OpenKNX/OpenKNX-RasPi-HAT/doc/Renderings/DualKNX_MicroBCU_RaspiHat_V00.03_3D_Render (Klein).png

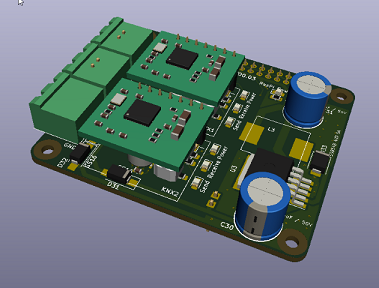
doc/Renderings/DualKNX_MicroBCU_RaspiHat_V00.03_3D_Render (Klein).png
