OpenKNX/OpenKNX-RasPi-HAT/doc/Pictures/IMG_20210311_140433009.jpg

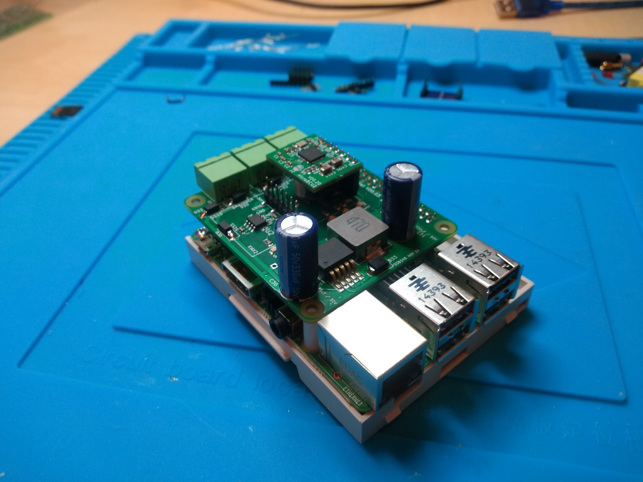
doc/Pictures/IMG_20210311_140433009.jpg
