OpenKNX/OpenKNX-RasPi-HAT/README.md

# OpenKNX-RasPi-HAT

see https://github.com/OpenKNX/OpenKNX/wiki/OpenKNX-RasPi-HAT
