OpenKNX/OpenKNX-RasPi-HAT/doc/DualKNX_MicroBCU_RaspiHat_Schematic_V00.03.png

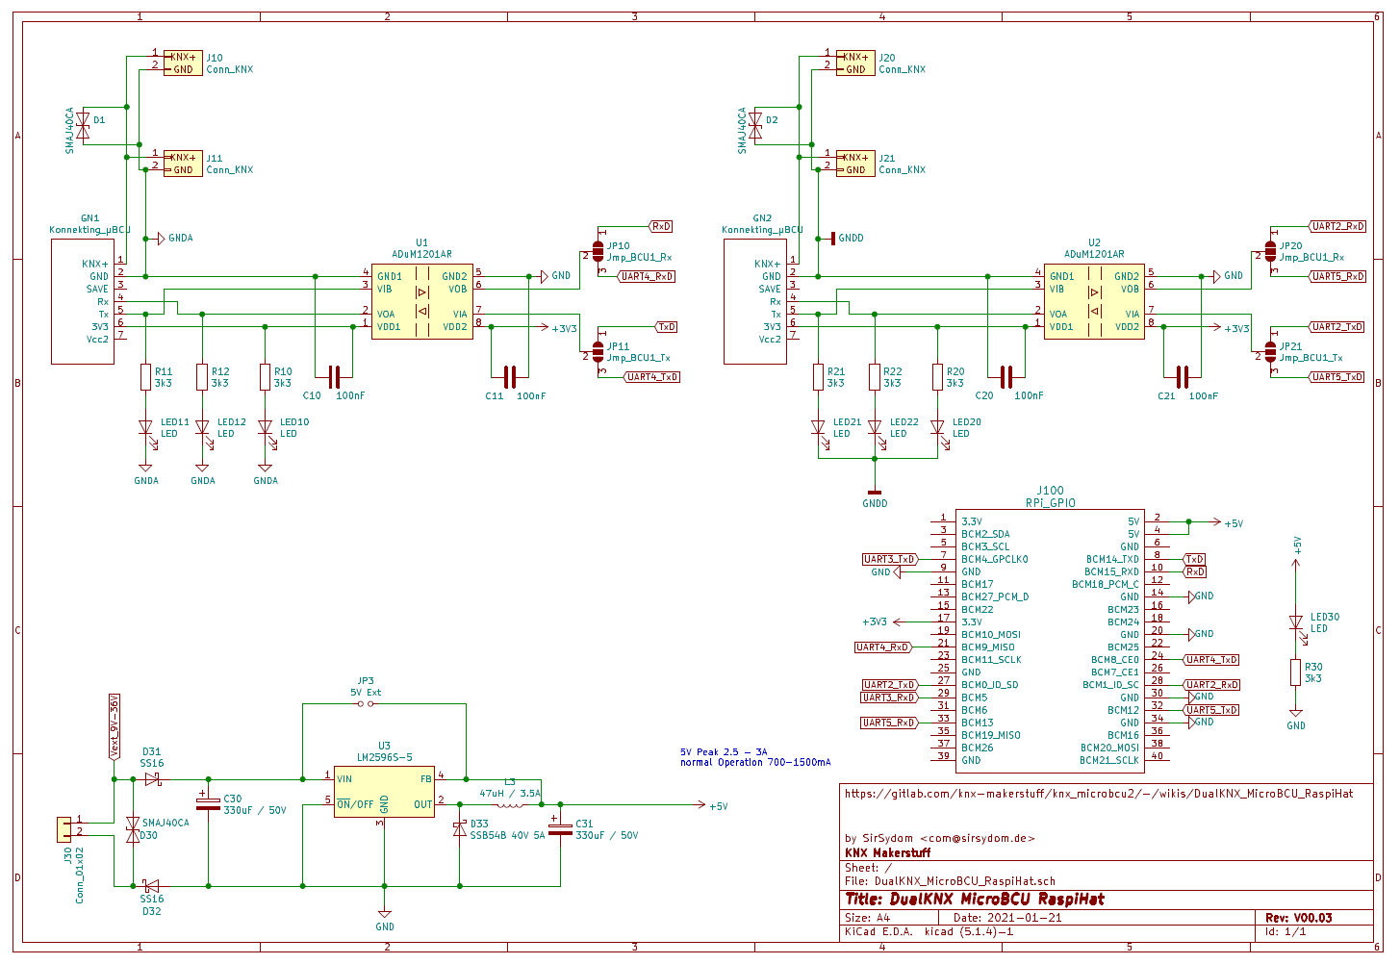
doc/DualKNX_MicroBCU_RaspiHat_Schematic_V00.03.png
