OpenKNX/OpenKNX-RasPi-HAT/doc/Pictures/IMG_20210310_144619610.jpg

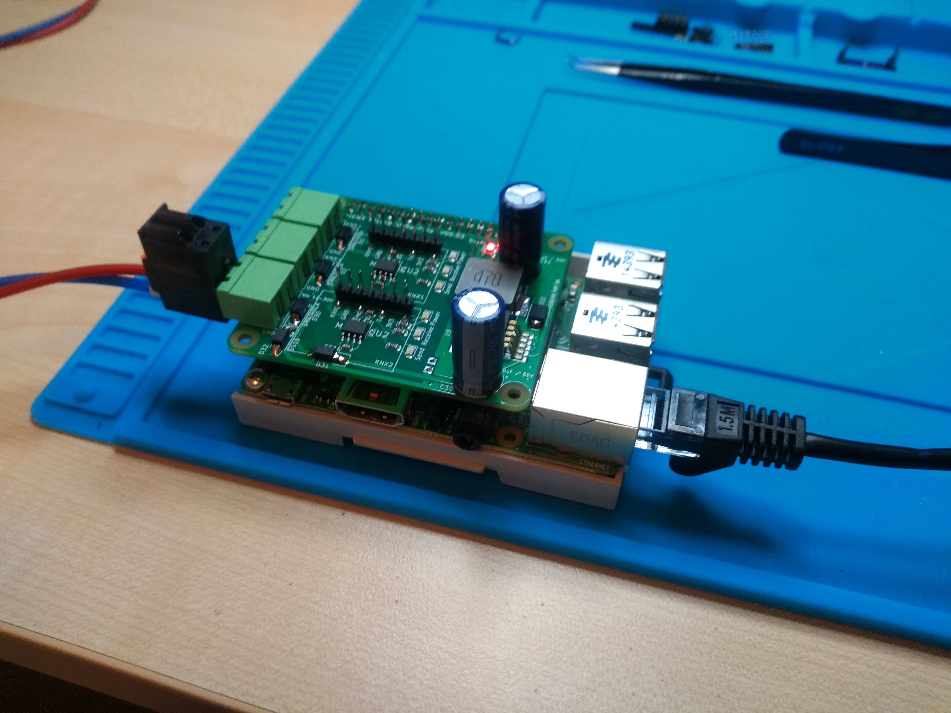
doc/Pictures/IMG_20210310_144619610.jpg
