OpenKNX/OpenKNX-RasPi-HAT/doc/Pictures/IMG_20210310_144640522.jpg

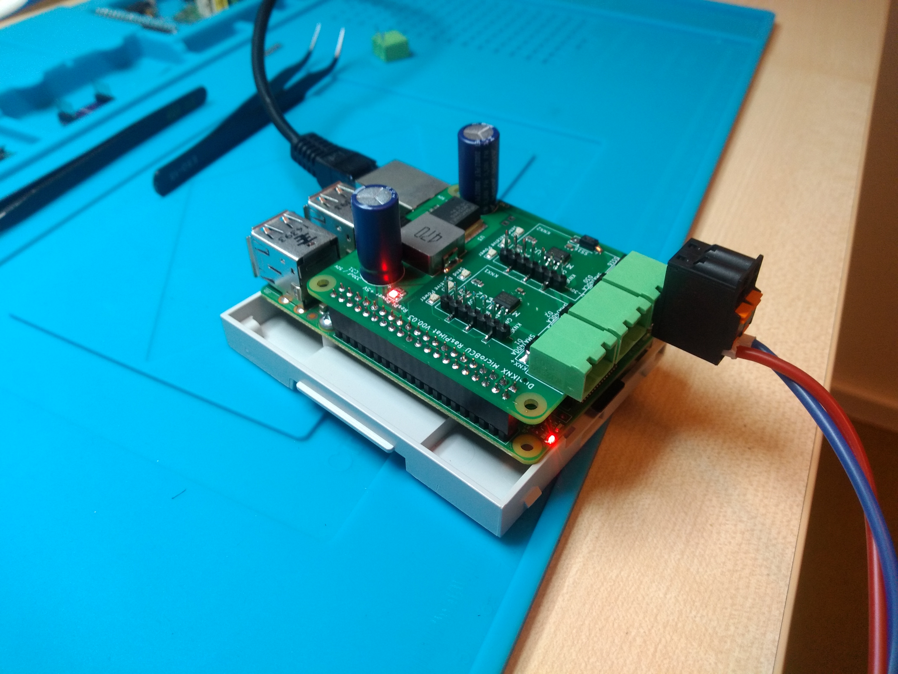
doc/Pictures/IMG_20210310_144640522.jpg
