OpenKNX/OpenKNX-RasPi-HAT/doc/Pictures/IMG_20210310_144718834.jpg

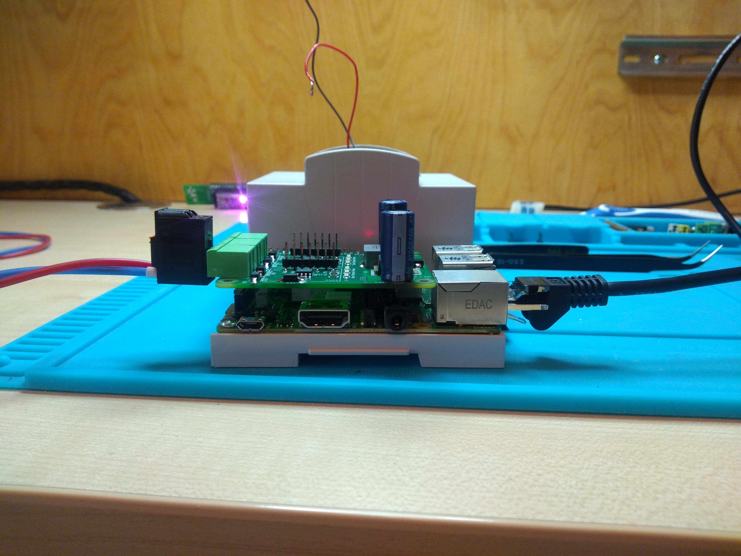
doc/Pictures/IMG_20210310_144718834.jpg
