OpenKNX/OpenKNX-RasPi-HAT/doc/Pictures/IMG_20210310_182440416.jpg

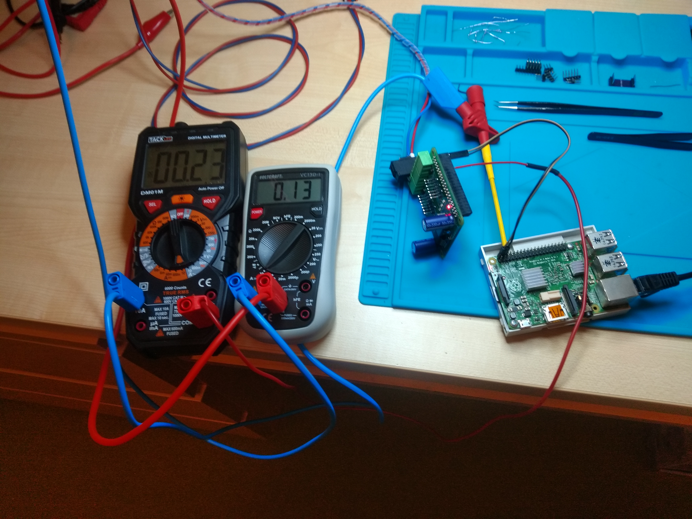
doc/Pictures/IMG_20210310_182440416.jpg
