OpenKNX/OpenKNX-RasPi-HAT/doc/Pictures/IMG_20210310_184042958.jpg

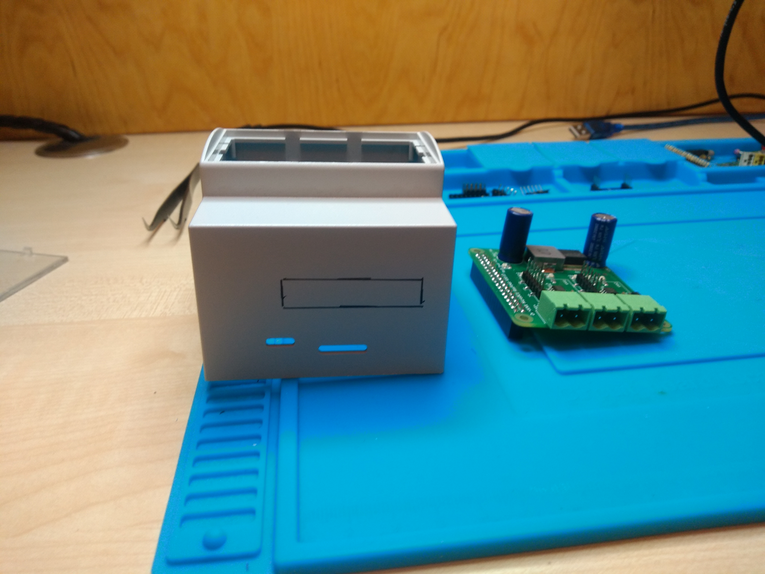
doc/Pictures/IMG_20210310_184042958.jpg
