OpenKNX/OpenKNX-RasPi-HAT/doc/Pictures/IMG_20210310_222531236.jpg

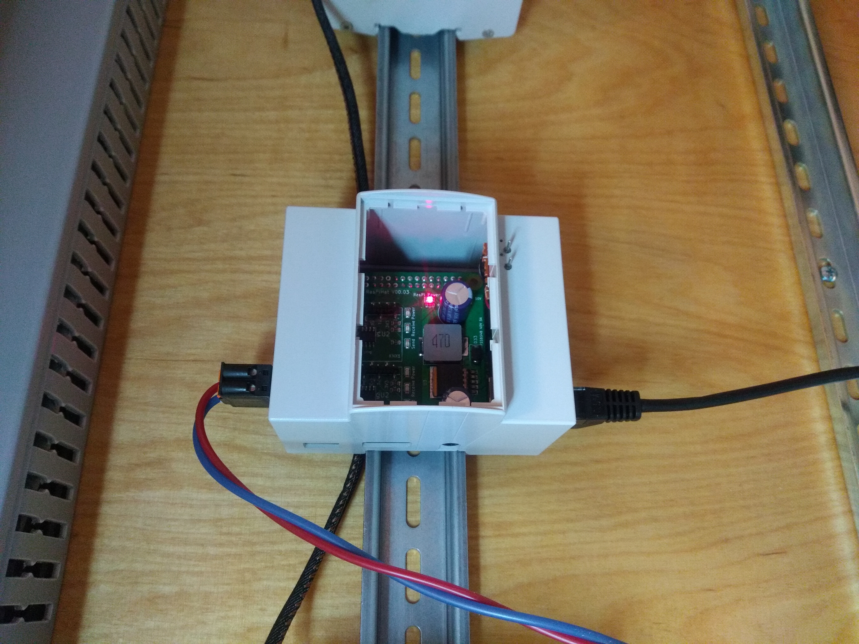
doc/Pictures/IMG_20210310_222531236.jpg
