OpenKNX/OpenKNX-RasPi-HAT/doc/Pictures/IMG_20210311_140428649.jpg

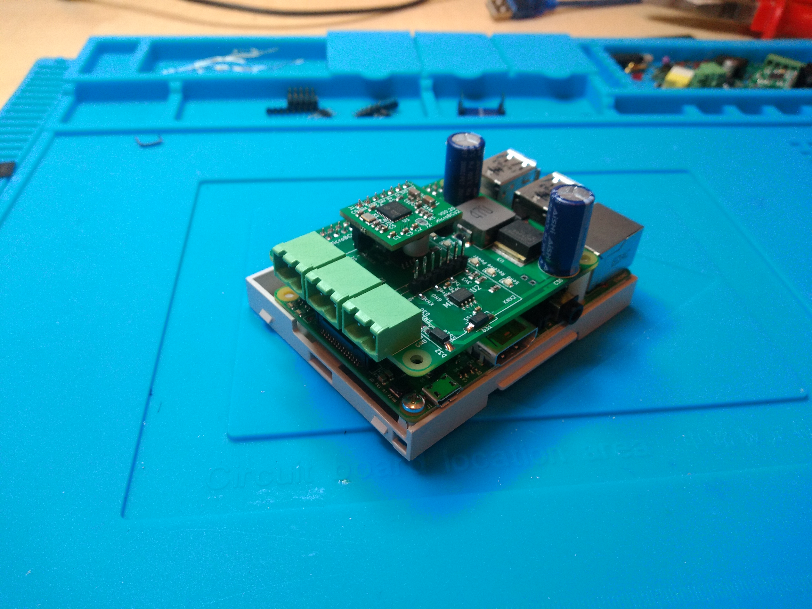
doc/Pictures/IMG_20210311_140428649.jpg
