OpenKNX/OpenKNX-RasPi-HAT/doc/Pictures/IMG_20210311_140438347.jpg

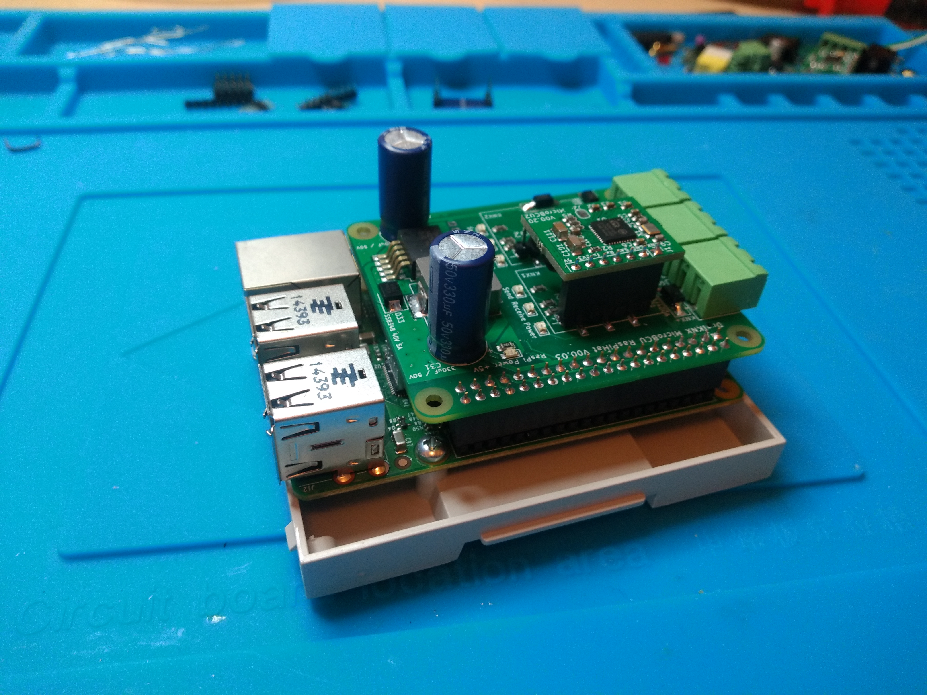
doc/Pictures/IMG_20210311_140438347.jpg
