OpenKNX/OpenKNX-RasPi-HAT/doc/Pictures/IMG_20210311_140441754.jpg

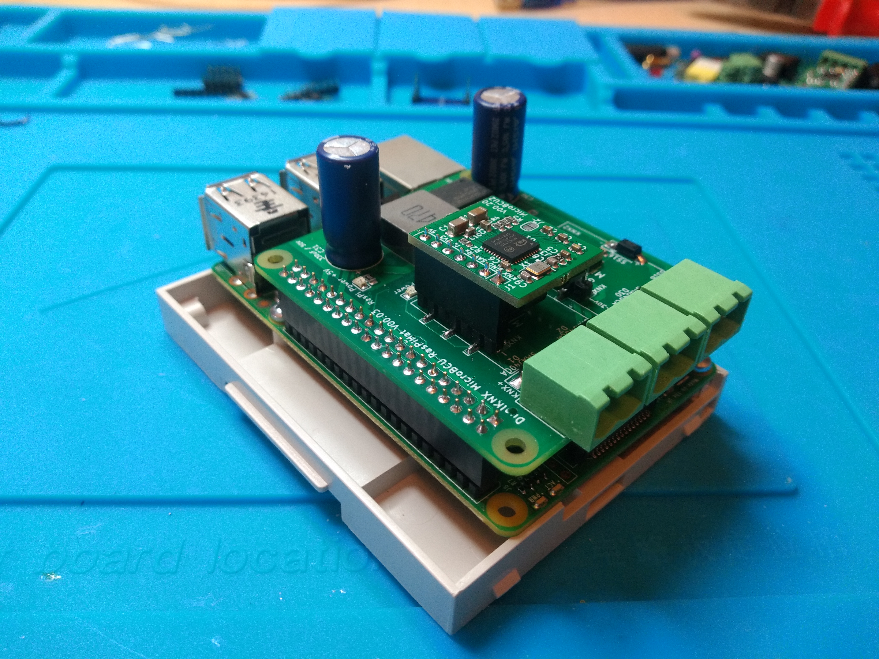
doc/Pictures/IMG_20210311_140441754.jpg
