OpenKNX/OpenKNX-RasPi-HAT/doc/Pictures/IMG_20210311_141130413 (Mittel).jpg

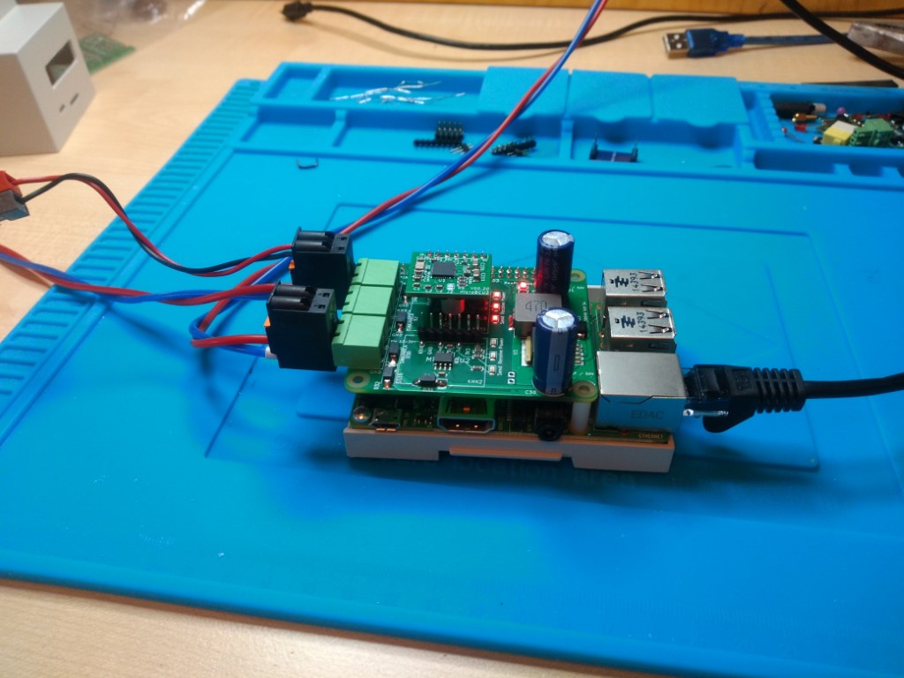
doc/Pictures/IMG_20210311_141130413 (Mittel).jpg
