OpenKNX/OpenKNX-RasPi-HAT/doc/Pictures/IMG_20210311_143212816 (Mittel).jpg

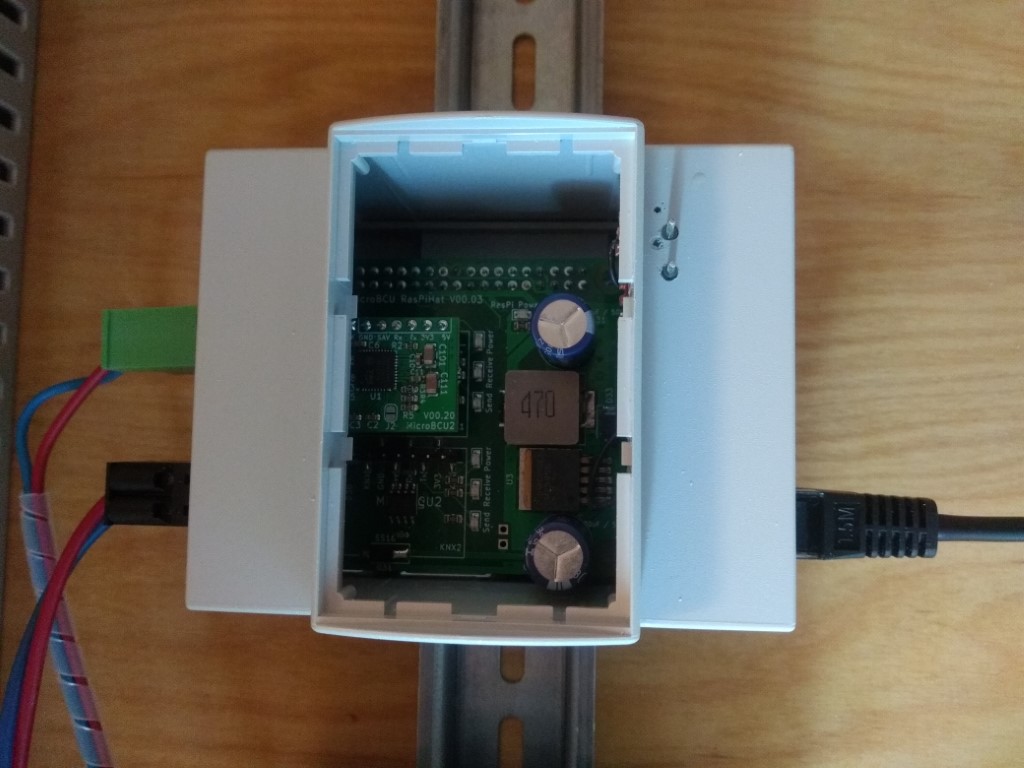
doc/Pictures/IMG_20210311_143212816 (Mittel).jpg
