OpenKNX/OpenKNX-RasPi-HAT/doc/Pictures/IMG_20210311_143313530 (Mittel).jpg

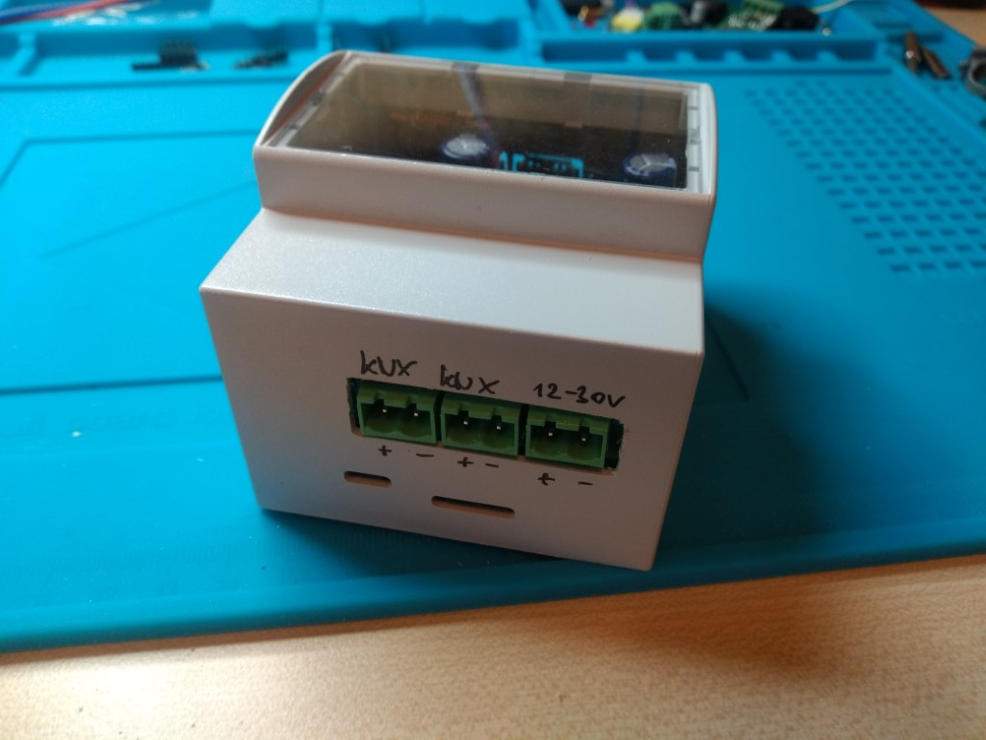
doc/Pictures/IMG_20210311_143313530 (Mittel).jpg
