OpenKNX/OpenKNX-RasPi-HAT/doc/Pictures/IMG_20210311_162232766.jpg

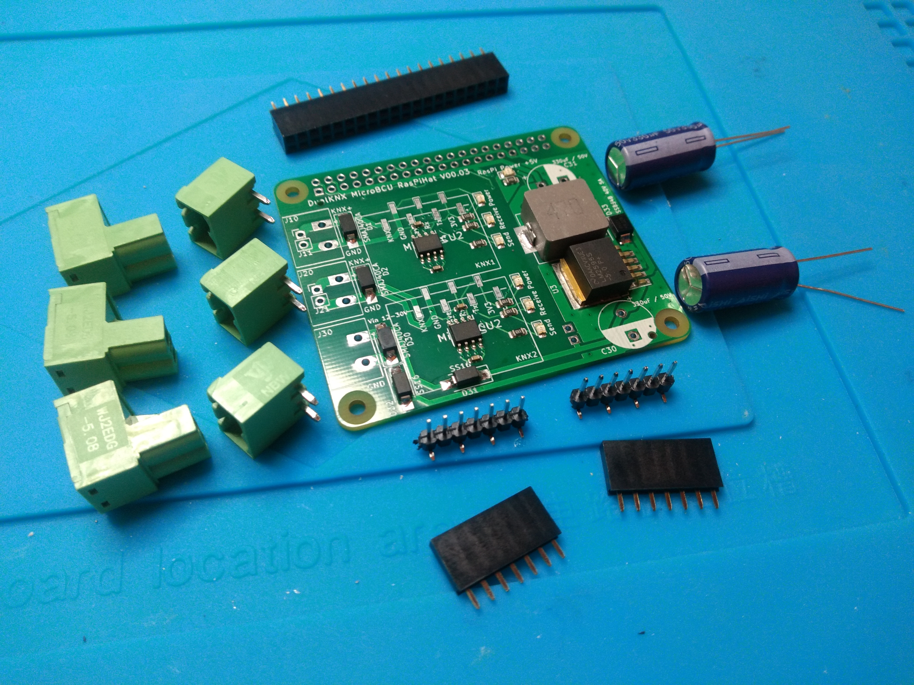
doc/Pictures/IMG_20210311_162232766.jpg
