OpenKNX/OpenKNX-RasPi-HAT/doc/Pictures/IMG_20210311_162318183.jpg

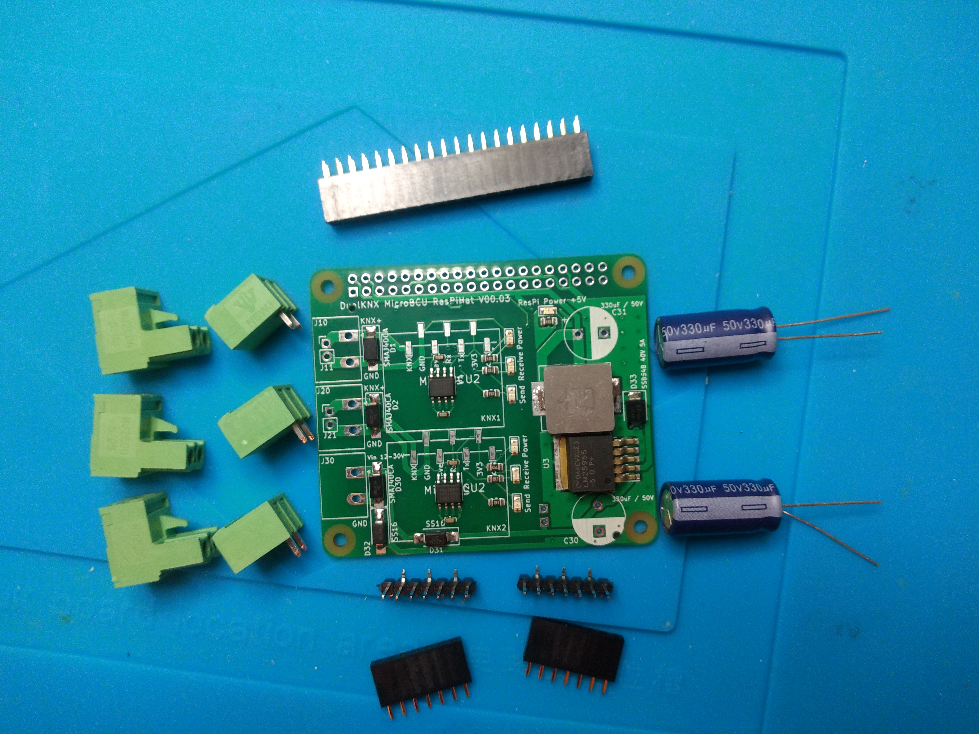
doc/Pictures/IMG_20210311_162318183.jpg
