OpenKNX/OpenKNX-RasPi-HAT/doc/Pictures/OpenKNX-RasPi-HAT_V00.20_kit.jpg

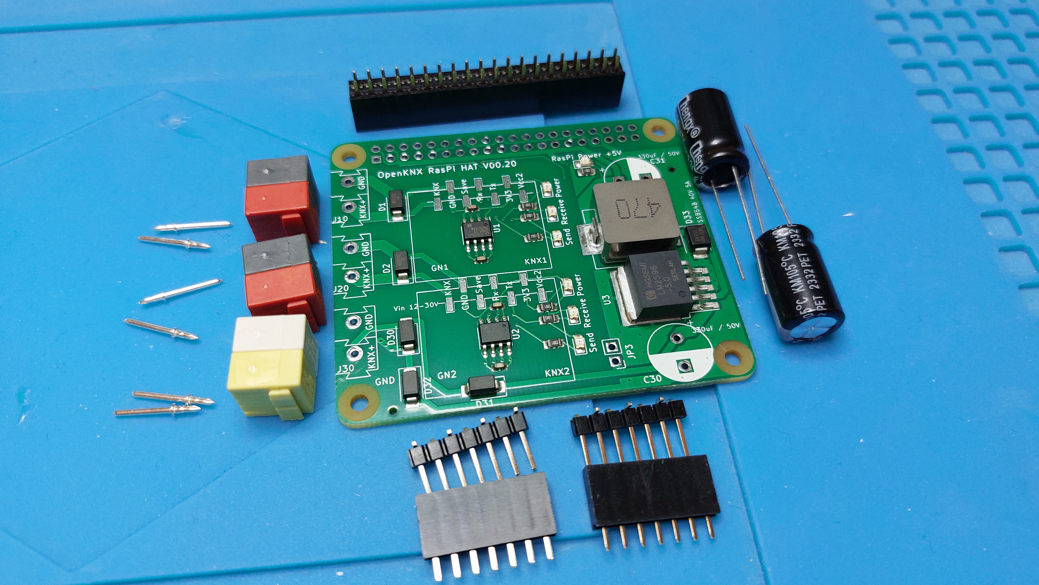
doc/Pictures/OpenKNX-RasPi-HAT_V00.20_kit.jpg
