OpenKNX/OpenKNX-RasPi-HAT/doc/Pictures/RasPi-Case_Prototype01 (Mittel).jpg

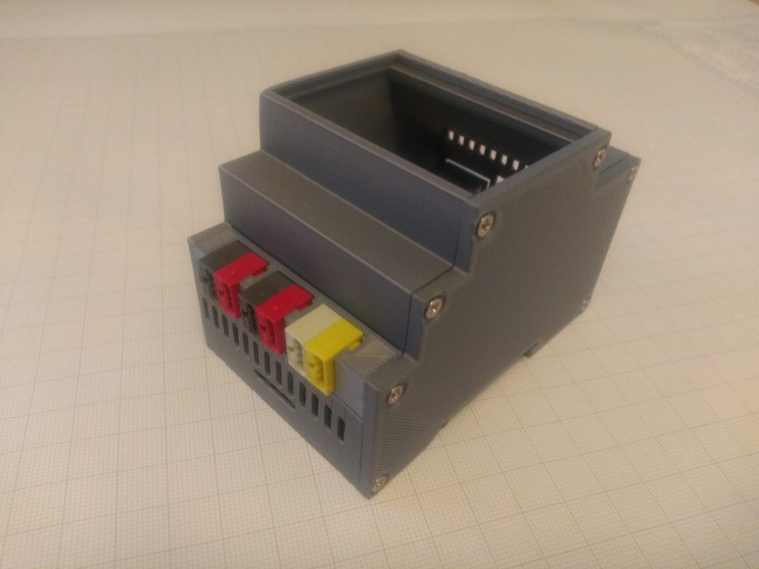
doc/Pictures/RasPi-Case_Prototype01 (Mittel).jpg
