OpenKNX/OpenKNX-RasPi-HAT/doc/Pictures/RasPi-Case_Prototype02.jpg

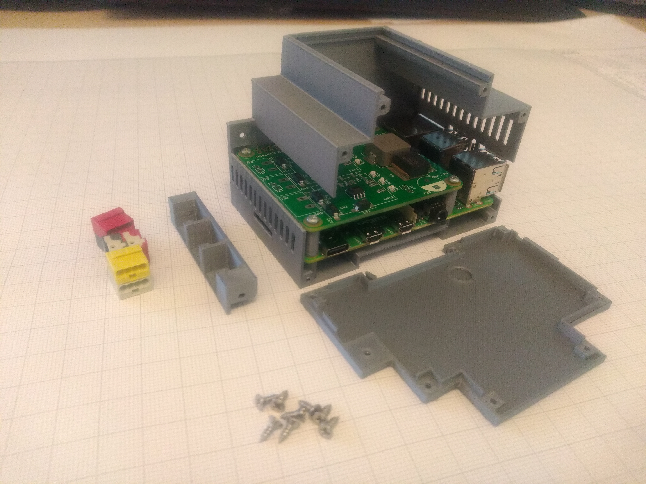
doc/Pictures/RasPi-Case_Prototype02.jpg
