OpenKNX/OpenKNX-RasPi-HAT/doc/Pictures/RasPi-Case_Prototype03.jpg

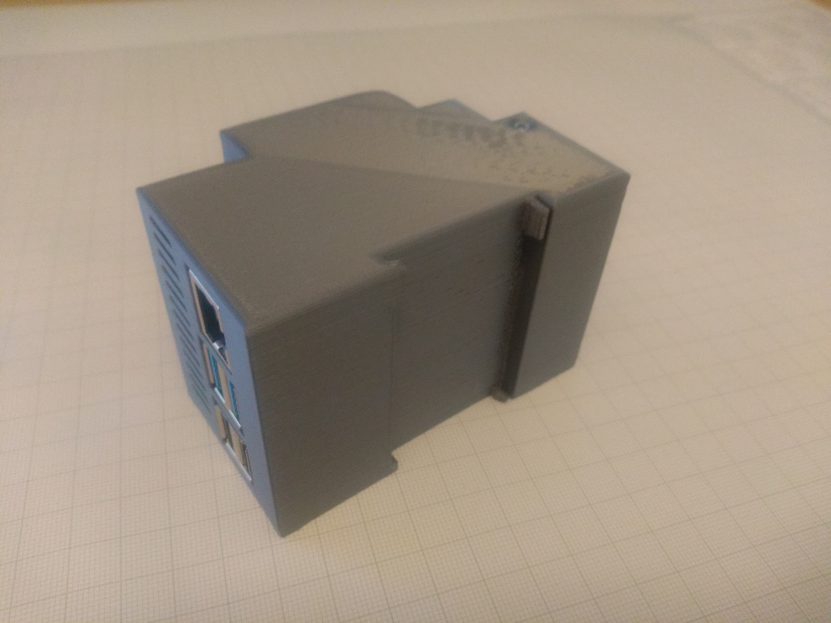
doc/Pictures/RasPi-Case_Prototype03.jpg
