OpenKNX/OpenKNX-RasPi-HAT/doc/RasPi-Case/OpenKNX-RasPi-Case_kit.jpg

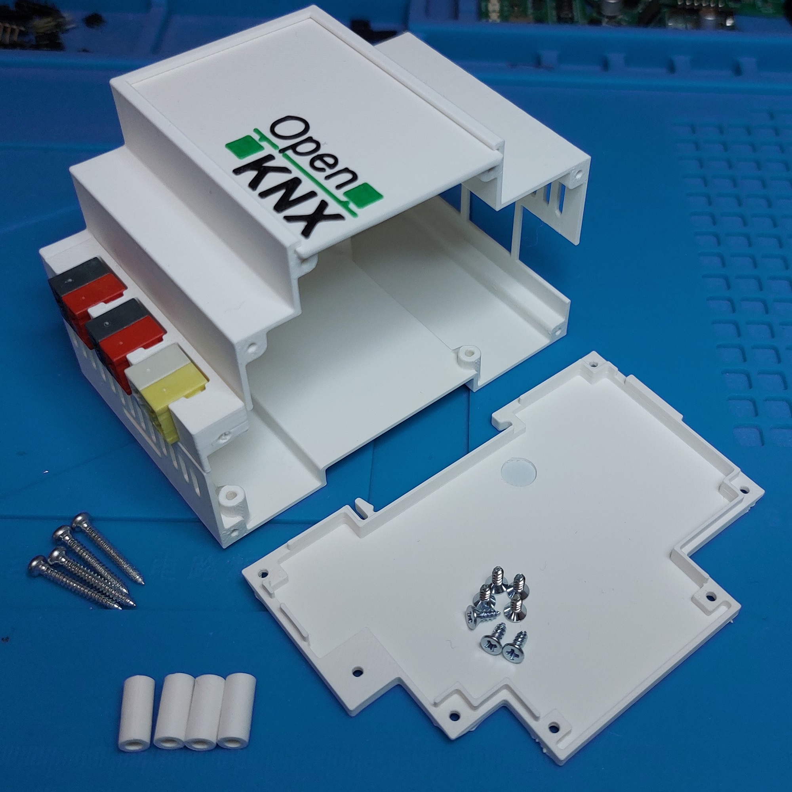
doc/RasPi-Case/OpenKNX-RasPi-Case_kit.jpg
