OpenKNX/OpenKNX-RasPi-HAT/doc/Renderings/3D_bot_V00.01.png

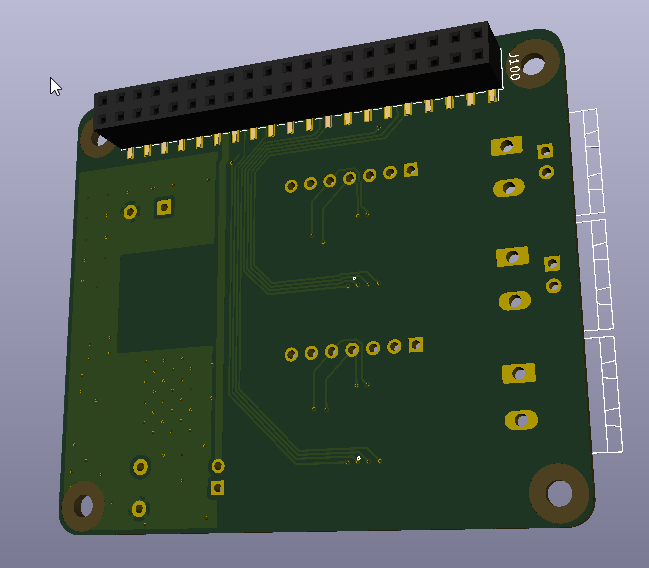
doc/Renderings/3D_bot_V00.01.png
