OpenKNX/OpenKNX-RasPi-HAT/doc/Renderings/DualKNX_MicroBCU_RaspiHat_V00.03_PCB_TOP_BOT.png

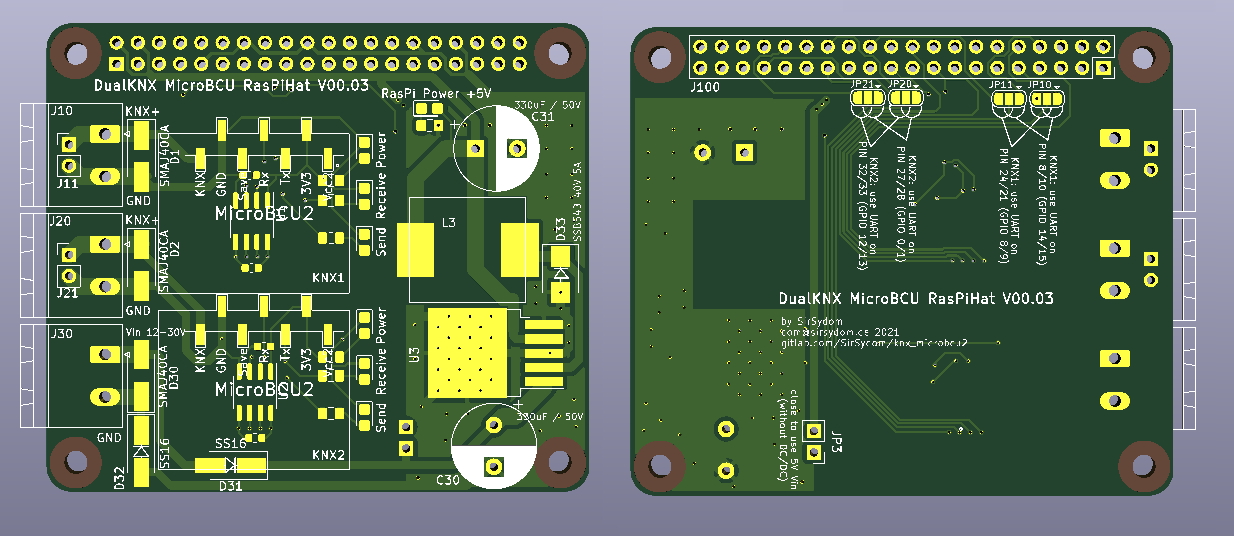
doc/Renderings/DualKNX_MicroBCU_RaspiHat_V00.03_PCB_TOP_BOT.png
