OpenKNX/OpenKNX-RasPi-HAT/doc/Renderings/RasPi-Case_Beta_Teaser.png

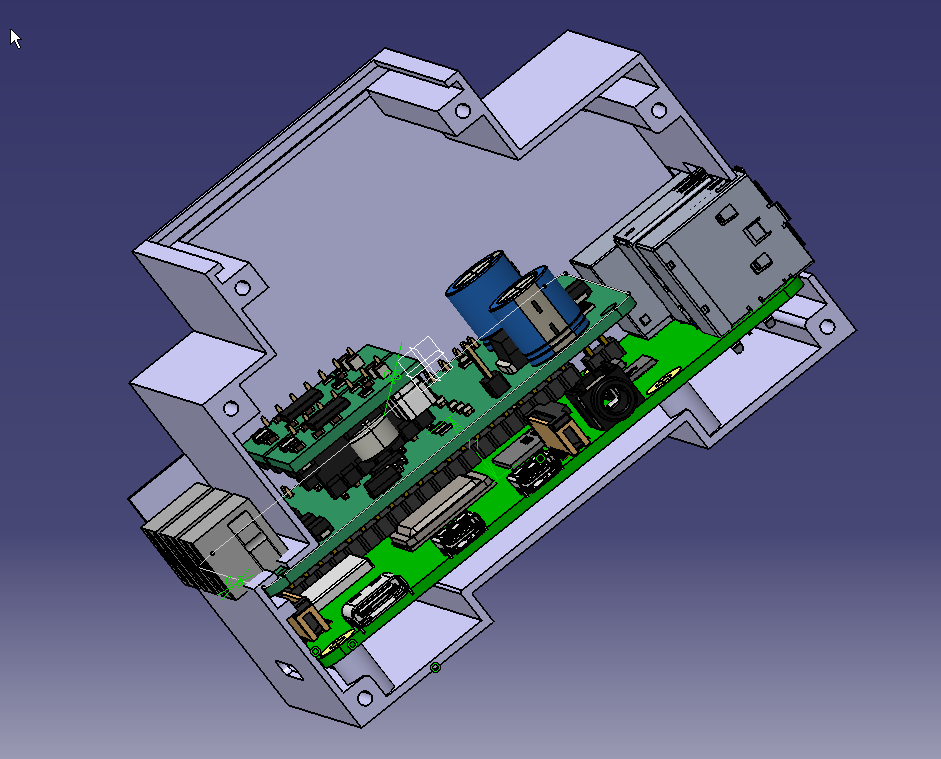
doc/Renderings/RasPi-Case_Beta_Teaser.png
