OpenKNX/OpenKNX-RasPi-HAT/doc/Renderings/UART_select_jumper.png

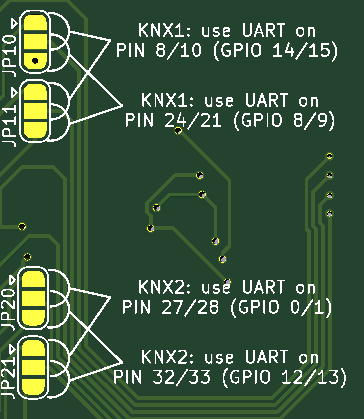
doc/Renderings/UART_select_jumper.png
