OpenKNX/OpenKNX-RasPi-HAT/hardware/EDA-Files/RasPi-HAT/RasPi-HAT_BOM.xlsx

Sheet: BOM
Designator | Package | Designation | LCSC No | JLCPCB | Value | Cost | Alt value | LCSC No | JLCPCB
C10 | C_0603_1608Metric | 100nF | C14663 (https://lcsc.com/product-detail/Multilayer-Ceramic-Capacitors-MLCC-SMD-SMT_100nF-104-10-50V_C14663.html/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) | basic | 100nF / 50V | 0.02
C11 | C_0603_1608Metric | 100nF | C14663 (https://lcsc.com/product-detail/Multilayer-Ceramic-Capacitors-MLCC-SMD-SMT_100nF-104-10-50V_C14663.html/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) | basic | 100nF / 50V | 0.02
C20 | C_0603_1608Metric | 100nF | C14663 (https://lcsc.com/product-detail/Multilayer-Ceramic-Capacitors-MLCC-SMD-SMT_100nF-104-10-50V_C14663.html/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) | basic | 100nF / 50V | 0.02
C21 | C_0603_1608Metric | 100nF | C14663 (https://lcsc.com/product-detail/Multilayer-Ceramic-Capacitors-MLCC-SMD-SMT_100nF-104-10-50V_C14663.html/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) | basic | 100nF / 50V | 0.02
C30 | CP_Radial_D10.0mm_P5.00mm | 330uF / 50V | C160195 (https://lcsc.com/product-detail/Aluminum-Electrolytic-Capacitors-Leaded_AISHI-Aihua-Group-ERJ1HM331G20OT_C160195.html) |  | 330uF / 50V | 0.18
C31 | CP_Radial_D10.0mm_P5.00mm | 330uF / 50V | C160195 (https://lcsc.com/product-detail/Aluminum-Electrolytic-Capacitors-Leaded_AISHI-Aihua-Group-ERJ1HM331G20OT_C160195.html) |  | 330uF / 50V | 0.18
D1 | D_SMA_Handsoldering | SMAJ40CA | C113970 | extended |  | 0.04
D2 | D_SMA_Handsoldering | SMAJ40CA | C113970 | extended |  | 0.04
D30 | D_SMA_Handsoldering | SMAJ40CA | C113970 | extended |  | 0.04
D31 | D_SMA_Handsoldering | SS16 | C2481 | extended |  | 0.016
D32 | D_SMA_Handsoldering | SS16 | C2481 | extended |  | 0.016
D33 | D_SMB | SS54B 40V 5A | C32513 (https://lcsc.com/product-detail/Schottky-Barrier-Diodes-SBD_MDD-Microdiode-Electronics-SS54B_C32513.html) | extended |  | 0.072
GN1 | MicroBCU2_PinSocket | SMD Header 1x7 |  | ebay |  | 0.07
GN1 | MicroBCU2_PinSocket | Female Header 1x7 | C124418 (https://lcsc.com/product-detail/Pin-Header-Female-Header_Ckmtw-Shenzhen-Cankemeng-C124418_C124418.html) | LCSC |  | 0.14
GN2 | MicroBCU2_PinSocket | SMD Header 1x7 |  | ebay |  | 0.07
GN2 | MicroBCU2_PinSocket | Female Header 1x7 | C124418 (https://lcsc.com/product-detail/Pin-Header-Female-Header_Ckmtw-Shenzhen-Cankemeng-C124418_C124418.html) | LCSC |  | 0.14
J100 | PinSocket_2x20_P2.54mm_Vertical | RPi_GPIO | C50982 (https://lcsc.com/product-detail/Pin-Header-Female-Header_BOOMELE-Boom-Precision-Elec-C50982_C50982.html) | LCSC |  | 0.18 |  | C35165 (https://lcsc.com/product-detail/Pin-Header-Female-Header_BOOMELE-Boom-Precision-Elec-C35165_C35165.html) | LCSC
J10 | PhoenixContact_MSTBA_2,5_2-G-5,08_1x02_P5.08mm_Horizontal | Conn_KNX | C3697 (https://lcsc.com/product-detail/Pluggable-System-Terminal-Block_Ningbo-Kangnex-Elec-WJ2EDGRC-5-08-2P_C3697.html) | LCSC |  | 0.033
J10 | PhoenixContact_MSTBA_2,5_2-G-5,08_1x02_P5.08mm_Horizontal | Conn_KNX | C71370 | LCSC |  | 0.148
J11 | PinHeader_1x02_P2.54mm_Vertical | Conn_KNX | C390678 (https://lcsc.com/product-detail/Pin-Header-Female-Header_PINREX-210-91-02GB01_C390678.html) | LCSC |  | 0.007
J20 | PhoenixContact_MSTBA_2,5_2-G-5,08_1x02_P5.08mm_Horizontal | Conn_KNX | C3697 (https://lcsc.com/product-detail/Pluggable-System-Terminal-Block_Ningbo-Kangnex-Elec-WJ2EDGRC-5-08-2P_C3697.html) | LCSC |  | 0.033
J20 | PhoenixContact_MSTBA_2,5_2-G-5,08_1x02_P5.08mm_Horizontal | Conn_KNX | C71370 | LCSC |  | 0.148
J21 | PinHeader_1x02_P2.54mm_Vertical | Conn_KNX | C390678 (https://lcsc.com/product-detail/Pin-Header-Female-Header_PINREX-210-91-02GB01_C390678.html) | LCSC |  | 0.007
J30 | PhoenixContact_MSTBA_2,5_2-G-5,08_1x02_P5.08mm_Horizontal | Conn_01x02 | C3697 (https://lcsc.com/product-detail/Pluggable-System-Terminal-Block_Ningbo-Kangnex-Elec-WJ2EDGRC-5-08-2P_C3697.html) | LCSC |  | 0.033
J30 | PhoenixContact_MSTBA_2,5_2-G-5,08_1x02_P5.08mm_Horizontal | Conn_01x02 | C71370 | LCSC |  | 0.148
JP3 | PinHeader_1x02_P2.54mm_Vertical | 5V Ext | C390678 (https://lcsc.com/product-detail/Pin-Header-Female-Header_PINREX-210-91-02GB01_C390678.html) | LCSC |  | 0.007
L3 | L_YJYCOIN_YSPI1365_13.8mmx12.6mm_H6.5mm | 47uH / 3.5A | C497913 (https://lcsc.com/product-detail/Power-Inductors_YJYCOIN-YSPI1365-470M_C497913.html) | extended |  | 0.47 |  | C526031 (https://lcsc.com/product-detail/Power-Inductors_cjiang-Changjiang-Microelectronics-Tech-FXL1360-470-M_C526031.html/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) | extended | C143967 (https://lcsc.com/product-detail/Power-Inductors_Sunlord-MWSA1004-470MT_C143967.html/?href=jlc-SMT) | extended
LED10 | LED_0805_2012Metric_Castellated | LED | C84256 (https://lcsc.com/product-detail/Light-Emitting-Diodes-LED_Red-LED-SMDLED-80-180mcd_C84256.html/?href=jlc-SMT) | basic |  | 0.02
LED11 | LED_0805_2012Metric_Castellated | LED | C84256 (https://lcsc.com/product-detail/Light-Emitting-Diodes-LED_Red-LED-SMDLED-80-180mcd_C84256.html/?href=jlc-SMT) | basic |  | 0.02
LED12 | LED_0805_2012Metric_Castellated | LED | C84256 (https://lcsc.com/product-detail/Light-Emitting-Diodes-LED_Red-LED-SMDLED-80-180mcd_C84256.html/?href=jlc-SMT) | basic |  | 0.02
LED20 | LED_0805_2012Metric_Castellated | LED | C84256 (https://lcsc.com/product-detail/Light-Emitting-Diodes-LED_Red-LED-SMDLED-80-180mcd_C84256.html/?href=jlc-SMT) | basic |  | 0.02
LED21 | LED_0805_2012Metric_Castellated | LED | C84256 (https://lcsc.com/product-detail/Light-Emitting-Diodes-LED_Red-LED-SMDLED-80-180mcd_C84256.html/?href=jlc-SMT) | basic |  | 0.02
LED22 | LED_0805_2012Metric_Castellated | LED | C84256 (https://lcsc.com/product-detail/Light-Emitting-Diodes-LED_Red-LED-SMDLED-80-180mcd_C84256.html/?href=jlc-SMT) | basic |  | 0.02
LED30 | LED_0805_2012Metric_Castellated | LED | C84256 (https://lcsc.com/product-detail/Light-Emitting-Diodes-LED_Red-LED-SMDLED-80-180mcd_C84256.html/?href=jlc-SMT) | basic |  | 0.02
R10 | R_0805_2012Metric_Pad1.15x1.40mm_HandSolder | 3k3 | C26010 (https://lcsc.com/product-detail/Chip-Resistor-Surface-Mount_Uniroyal-Elec-0805W8F3301T5E_C26010.html/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) | basic |  | 0.004
R11 | R_0805_2012Metric_Pad1.15x1.40mm_HandSolder | 3k3 | C26010 (https://lcsc.com/product-detail/Chip-Resistor-Surface-Mount_Uniroyal-Elec-0805W8F3301T5E_C26010.html/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) | basic |  | 0.004
R12 | R_0805_2012Metric_Pad1.15x1.40mm_HandSolder | 3k3 | C26010 (https://lcsc.com/product-detail/Chip-Resistor-Surface-Mount_Uniroyal-Elec-0805W8F3301T5E_C26010.html/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) | basic |  | 0.004
R20 | R_0805_2012Metric_Pad1.15x1.40mm_HandSolder | 3k3 | C26010 (https://lcsc.com/product-detail/Chip-Resistor-Surface-Mount_Uniroyal-Elec-0805W8F3301T5E_C26010.html/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) | basic |  | 0.004
R21 | R_0805_2012Metric_Pad1.15x1.40mm_HandSolder | 3k3 | C26010 (https://lcsc.com/product-detail/Chip-Resistor-Surface-Mount_Uniroyal-Elec-0805W8F3301T5E_C26010.html/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) | basic |  | 0.004
R22 | R_0805_2012Metric_Pad1.15x1.40mm_HandSolder | 3k3 | C26010 (https://lcsc.com/product-detail/Chip-Resistor-Surface-Mount_Uniroyal-Elec-0805W8F3301T5E_C26010.html/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) | basic |  | 0.004
R30 | R_0805_2012Metric_Pad1.15x1.40mm_HandSolder | 3k3 | C26010 (https://lcsc.com/product-detail/Chip-Resistor-Surface-Mount_Uniroyal-Elec-0805W8F3301T5E_C26010.html/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) | basic |  | 0.004
U1 | SOIC-8_3.9x4.9mm_P1.27mm | ADuM1201AR | C9669 (https://lcsc.com/product-detail/Digital-Isolators_ADI_ADUM1201ARZ-RL7_ADUM1201ARZ-RL7_C9669.html/?href=jlc-SMT) | basic |  | 3.5 |  | C428879 | extended
U2 | SOIC-8_3.9x4.9mm_P1.27mm | ADuM1201AR | C9669 (https://lcsc.com/product-detail/Digital-Isolators_ADI_ADUM1201ARZ-RL7_ADUM1201ARZ-RL7_C9669.html/?href=jlc-SMT) | basic |  | 3.5 |  | C428879 | extended
U3 | TO-263-5_TabPin3 | LM2596S-5 | C10002 (https://lcsc.com/product-detail/DC-DC-Converters_TI_LM2596SX-5-0-NOPB_LM2596SX-5-0-NOPB_C10002.html/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) | basic |  | 2.15 |  | C194349 | extended

Sheet: Partlist KIT
C30,C31 | CP_Radial_D10.0mm_P5.00mm | 330uF / 50V | C160195 (https://lcsc.com/product-detail/Aluminum-Electrolytic-Capacitors-Leaded_AISHI-Aihua-Group-ERJ1HM331G20OT_C160195.html) | 2
J10,J20,J30 | PhoenixContact_MSTBA_2,5_2-G-5,08_1x02_P5.08mm_Horizontal | Conn_KNX | C3697 (https://lcsc.com/product-detail/Pluggable-System-Terminal-Block_Ningbo-Kangnex-Elec-WJ2EDGRC-5-08-2P_C3697.html) | 3
J100 | PinSocket_2x20_P2.54mm_Vertical_SMD | RPi_GPIO | C52611 (https://lcsc.com/product-detail/Pin-Header-Female-Header_BOOMELE-Boom-Precision-Elec-C52611_C52611.html) | 1
J11,J21,GN1, GN2 | PinHeader 1x20 |  |  | 1
J10,J20,J30 | Gegenstück MSTBA |  | C71370 (https://lcsc.com/product-detail/Pluggable-System-Terminal-Block_Ningbo-Kangnex-Elec-WJ2EDGK-5-08-2P_C71370.html) | 3
GN1, GN2 | 1x07 Buchse |  | C124418 (https://lcsc.com/product-detail/Pin-Header-Female-Header_Ckmtw-Shenzhen-Cankemeng-C124418_C124418.html) | 2
