OpenKNX/OpenKNX-RasPi-HAT/doc/RasPi-Case/RasPi_Main_Case.stl

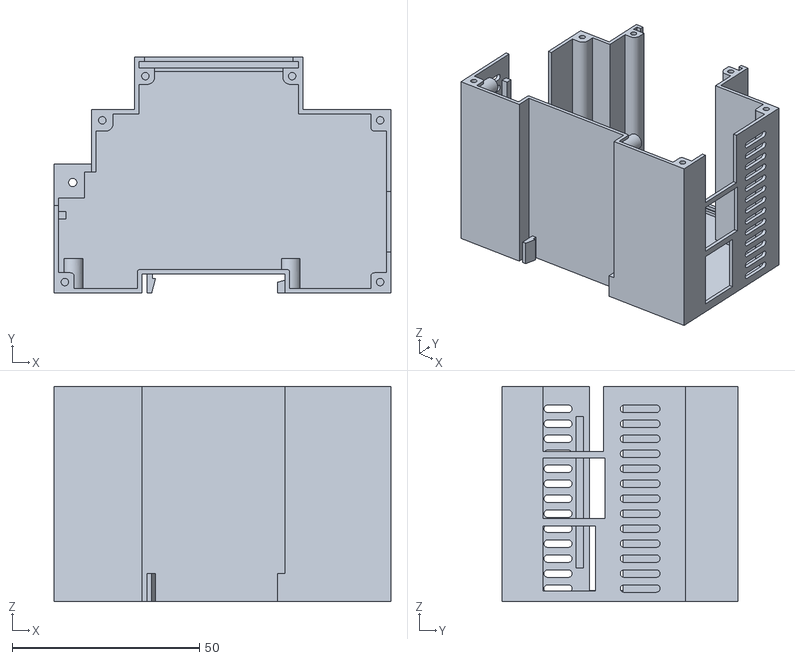
[picture p32: CAD file, 2023-01-25]
doc/RasPi-Case/RasPi_Main_Case.stl
90.0 x 63.0 x 57.5
