OpenKNX/OpenKNX-RasPi-HAT/doc/RasPi-Case/RasPi_Main_CaseCover.stl

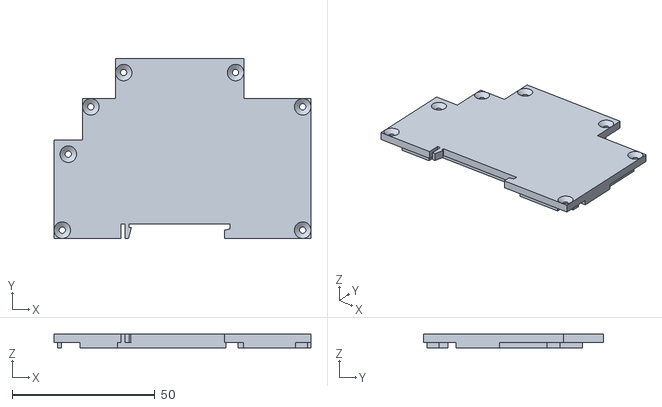
[picture p33: CAD file, 2023-01-25]
doc/RasPi-Case/RasPi_Main_CaseCover.stl
90.0 x 63.0 x 5.00
