OpenKNX/OpenKNX-RasPi-HAT/doc/RasPi-Case/RasPi-Case_Spacer11mm.stl

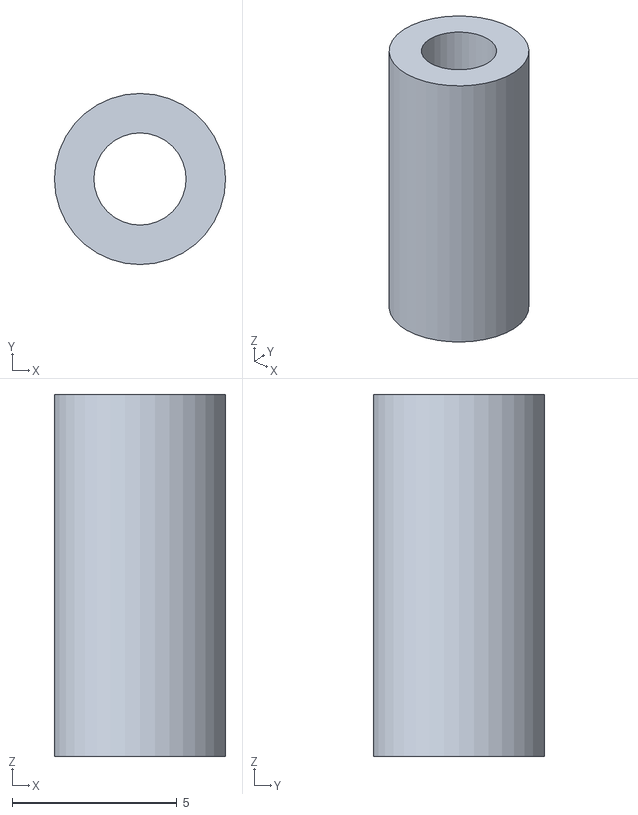
[picture p35: CAD file, 2023-01-25]
doc/RasPi-Case/RasPi-Case_Spacer11mm.stl
5.20 x 5.20 x 11.0
