OpenKNX/OpenKNX-RasPi-HAT/doc/RasPi-Case/RasPi-Case_Wago-Adapter.stl

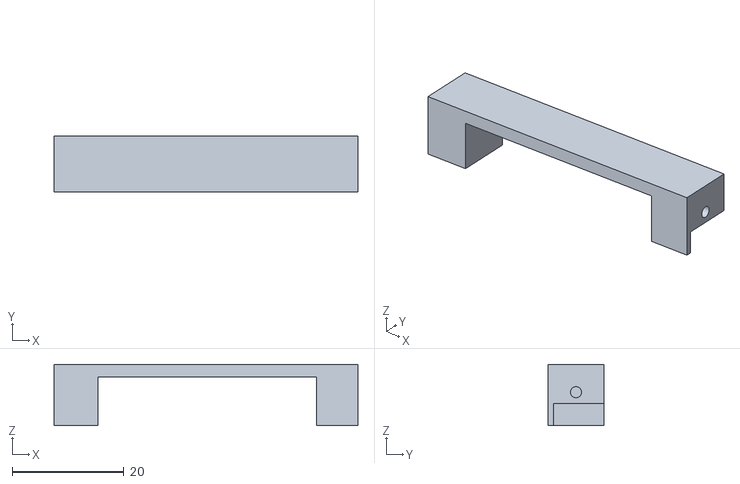
[picture p36: CAD file, 2023-01-25]
doc/RasPi-Case/RasPi-Case_Wago-Adapter.stl
54.5 x 10.0 x 11.0
