OpenKNX/OpenKNX-RasPi-HAT/doc/RasPi-HAT_Schematic_V00.20.pdf

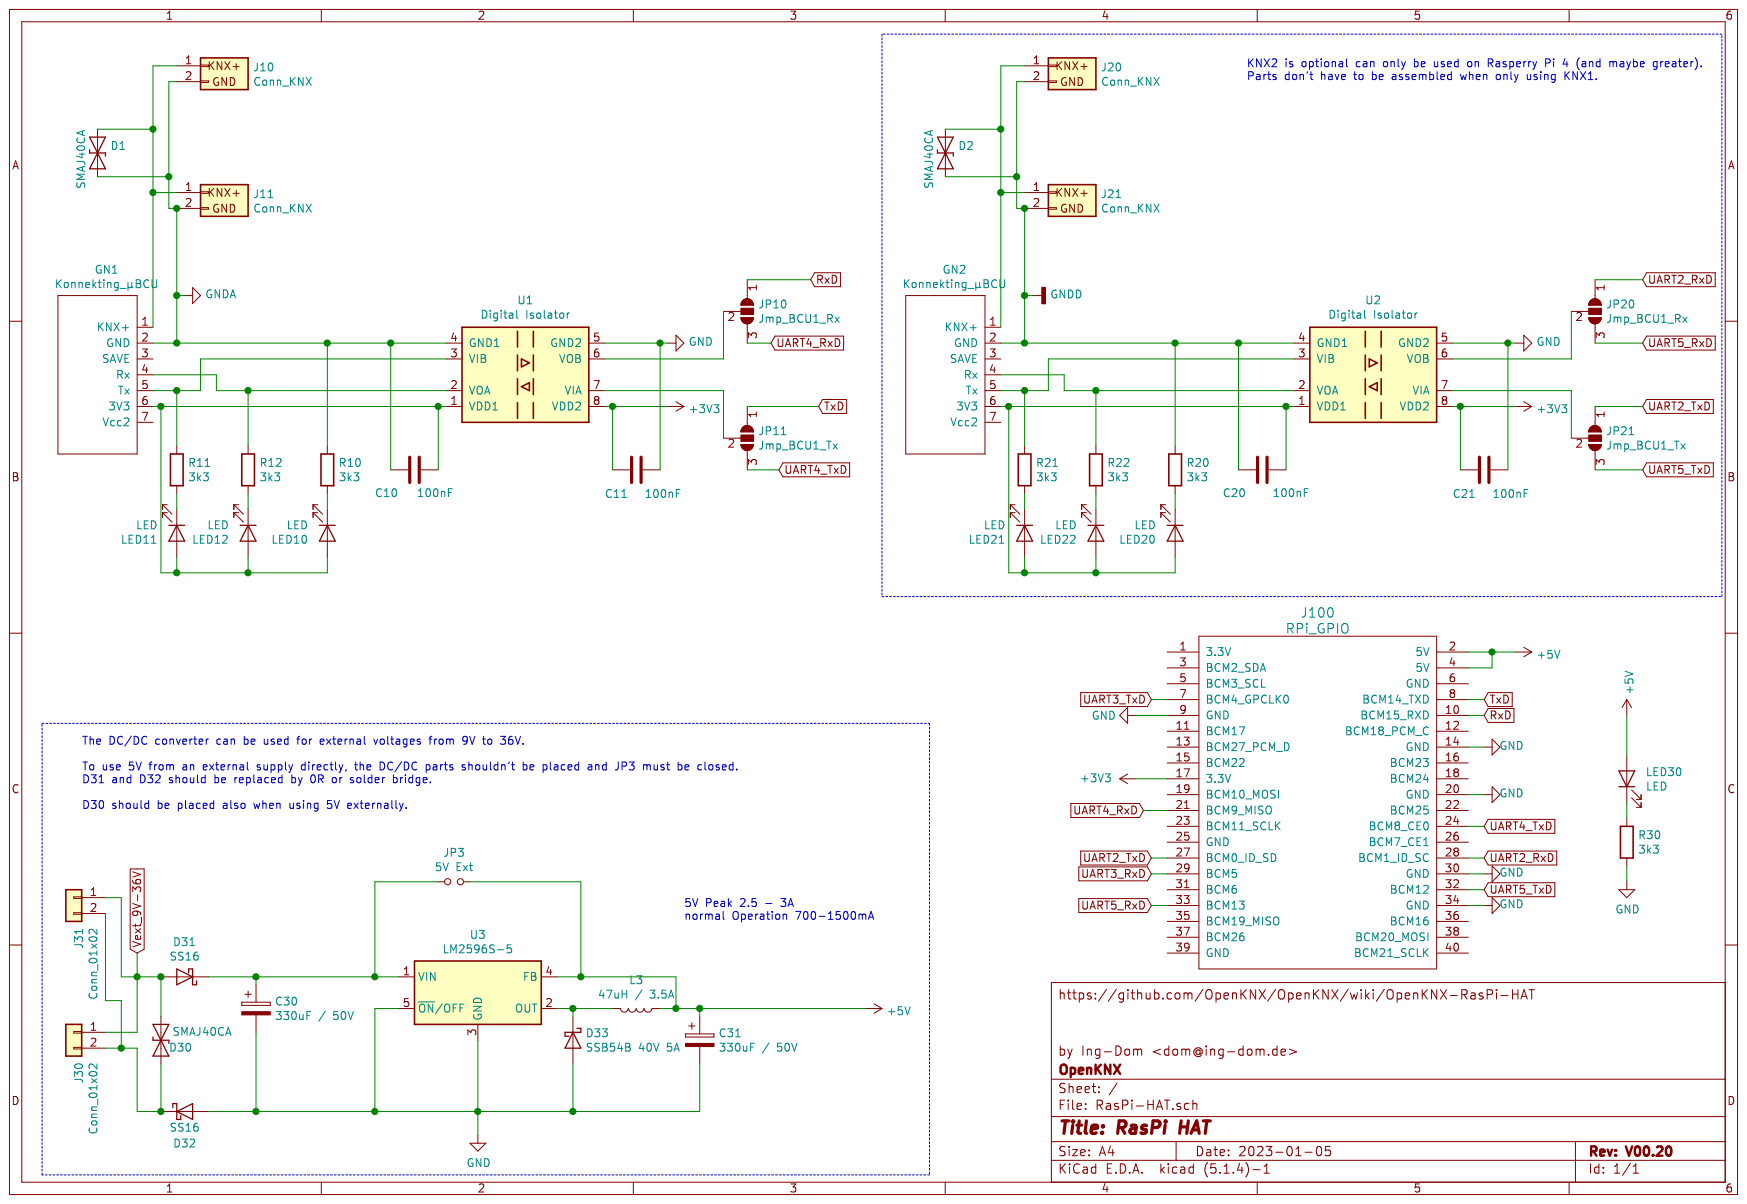
[picture p37: page 1]
