OpenKNX/OpenKNX-RasPi-HAT/doc/DualKNX_MicroBCU_RaspiHat_Schematic_V00.04.pdf

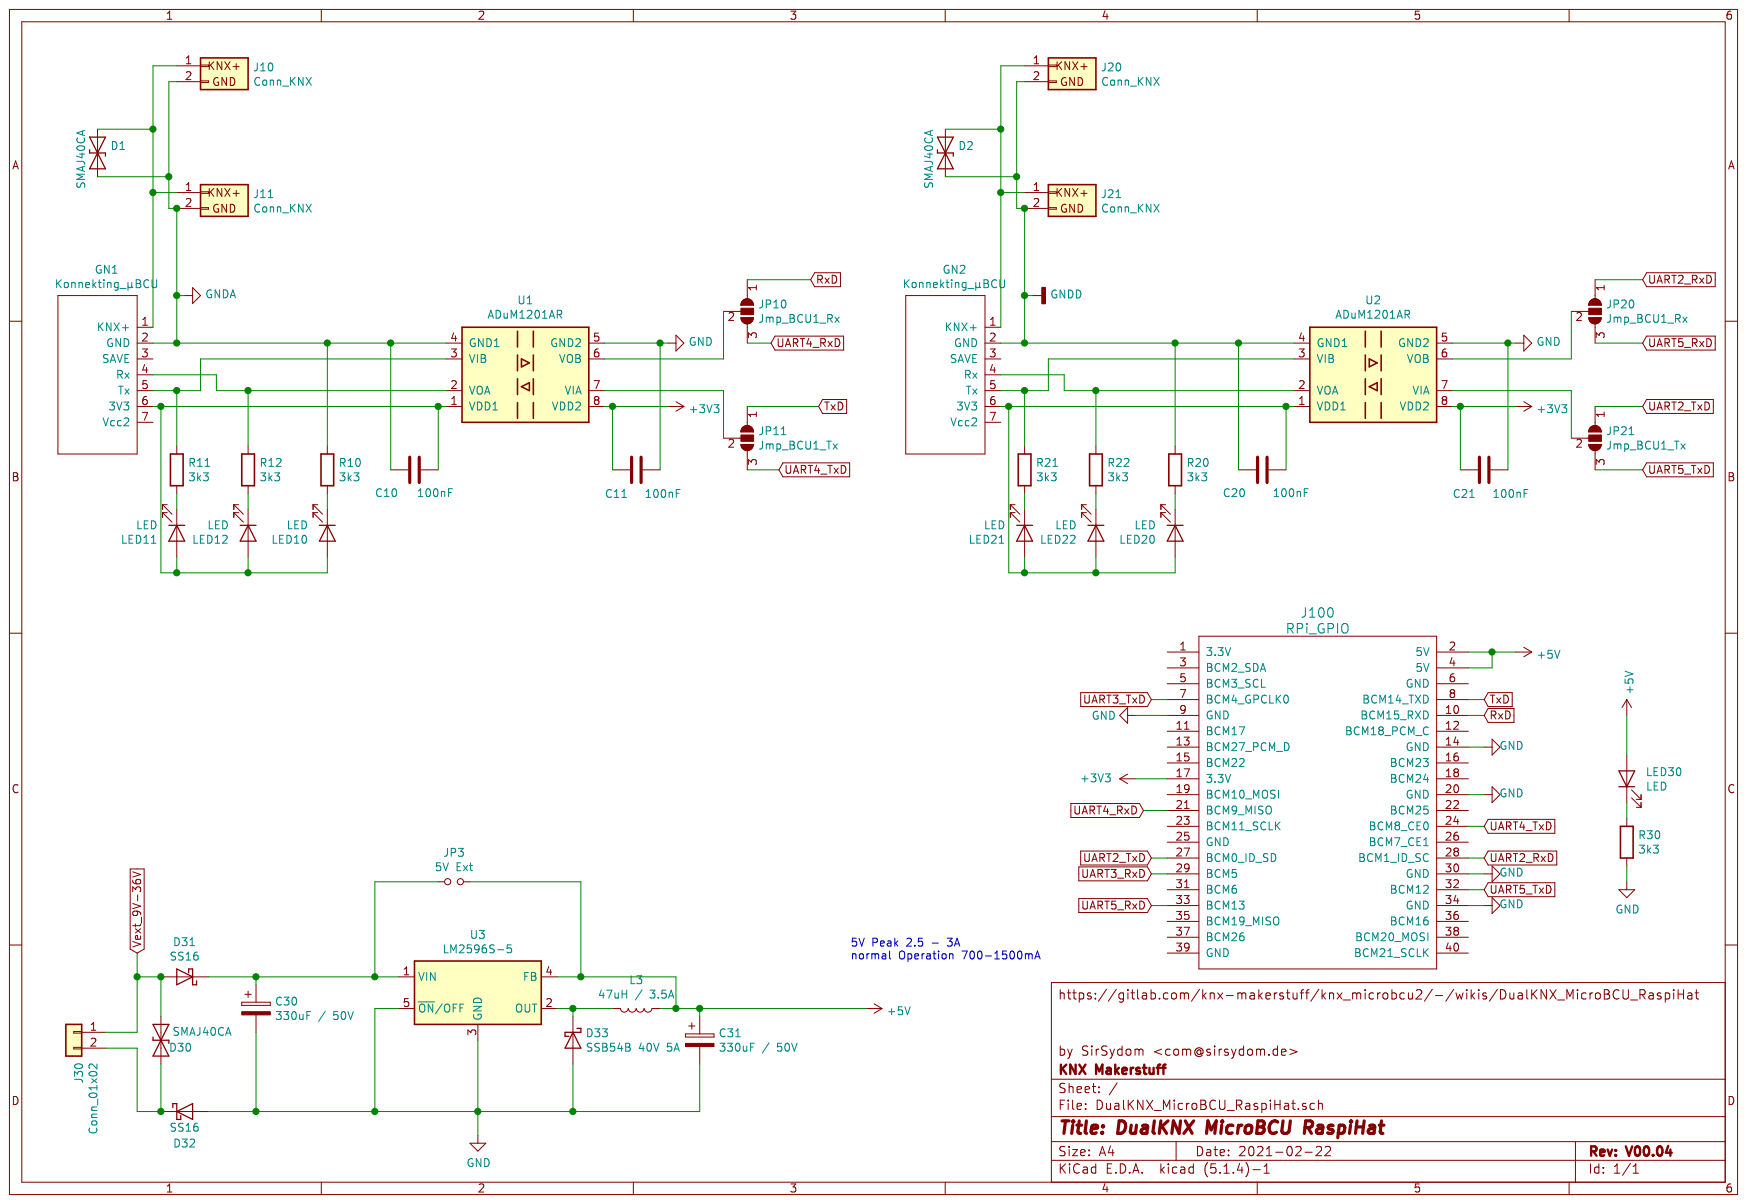
[picture p38: page 1]
