OpenKNX/OpenKNX-RasPi-HAT/doc/RasPi-HAT_Schematic_V00.10.pdf

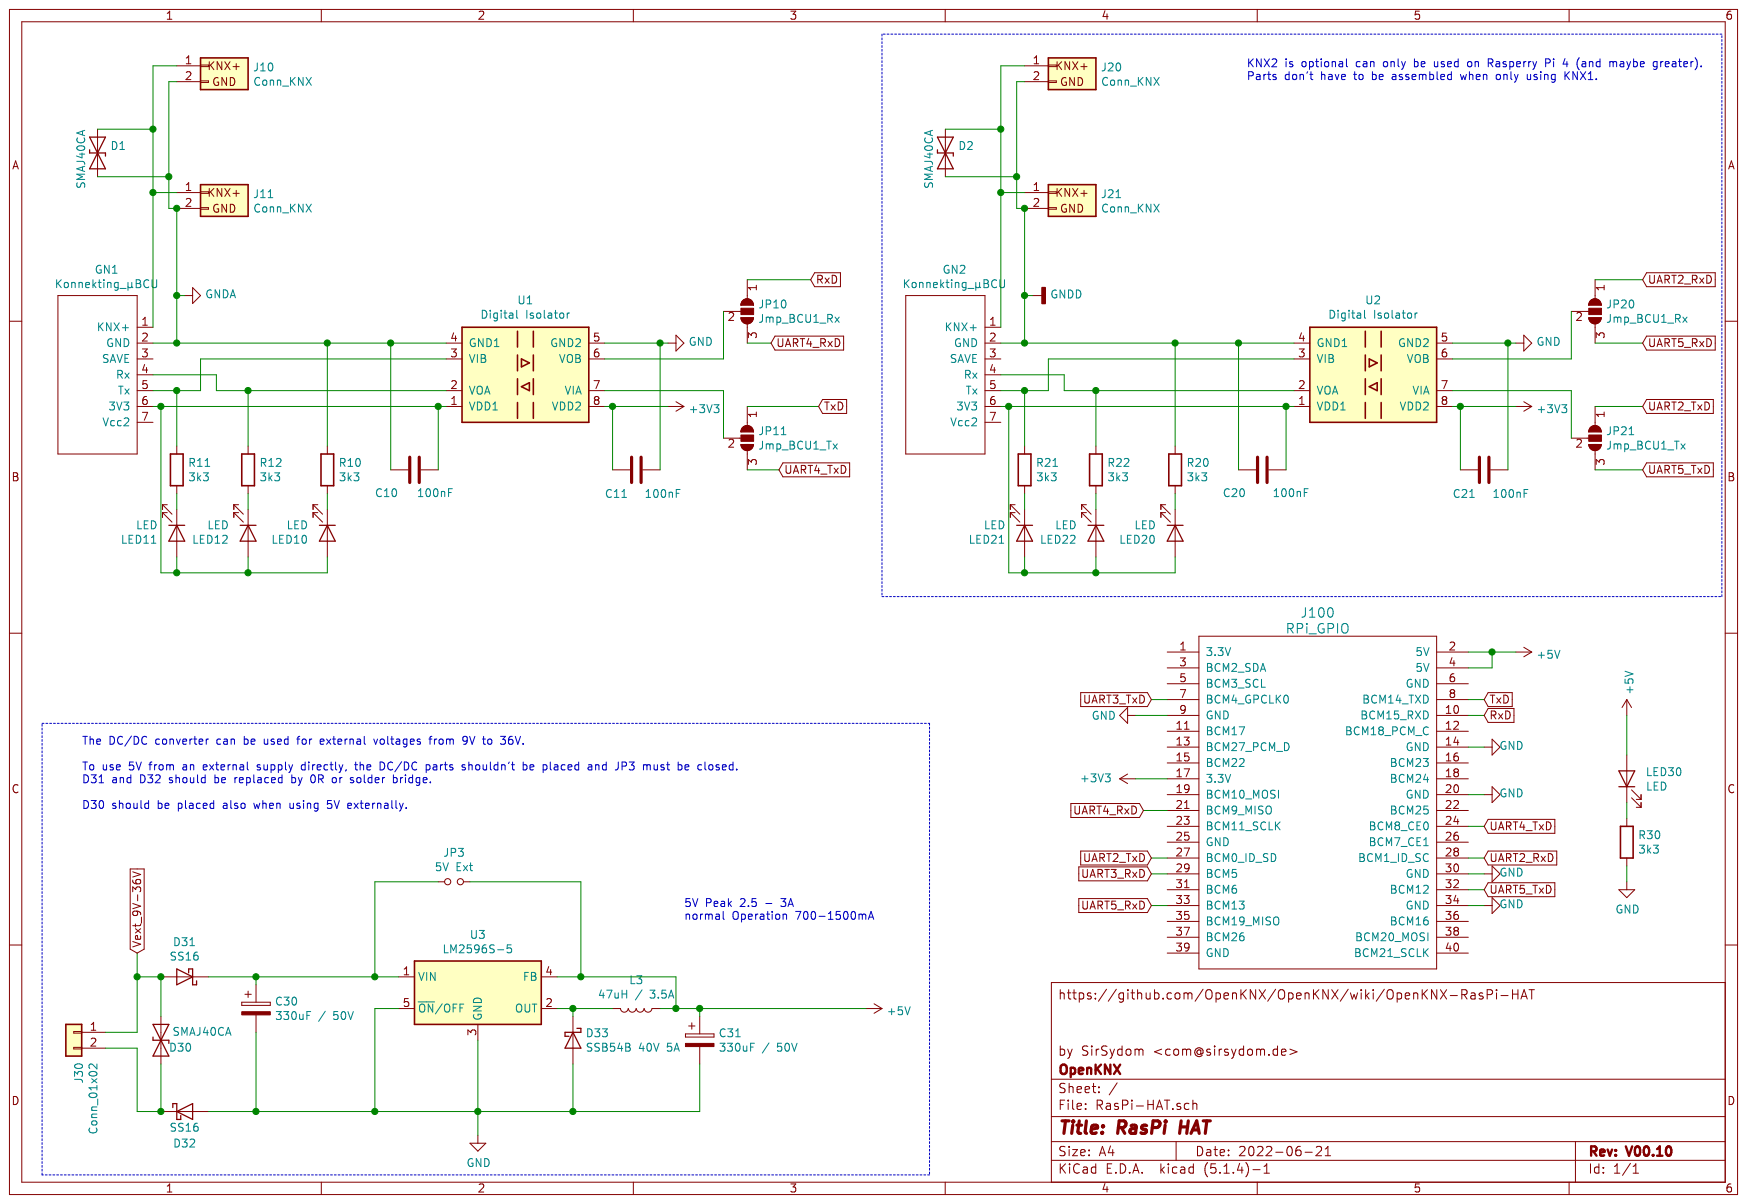
[picture p39: page 1]
