OpenKNX/OpenKNX-RasPi-HAT/doc/DualKNX_MicroBCU_RaspiHat_Schematic_V00.01.pdf

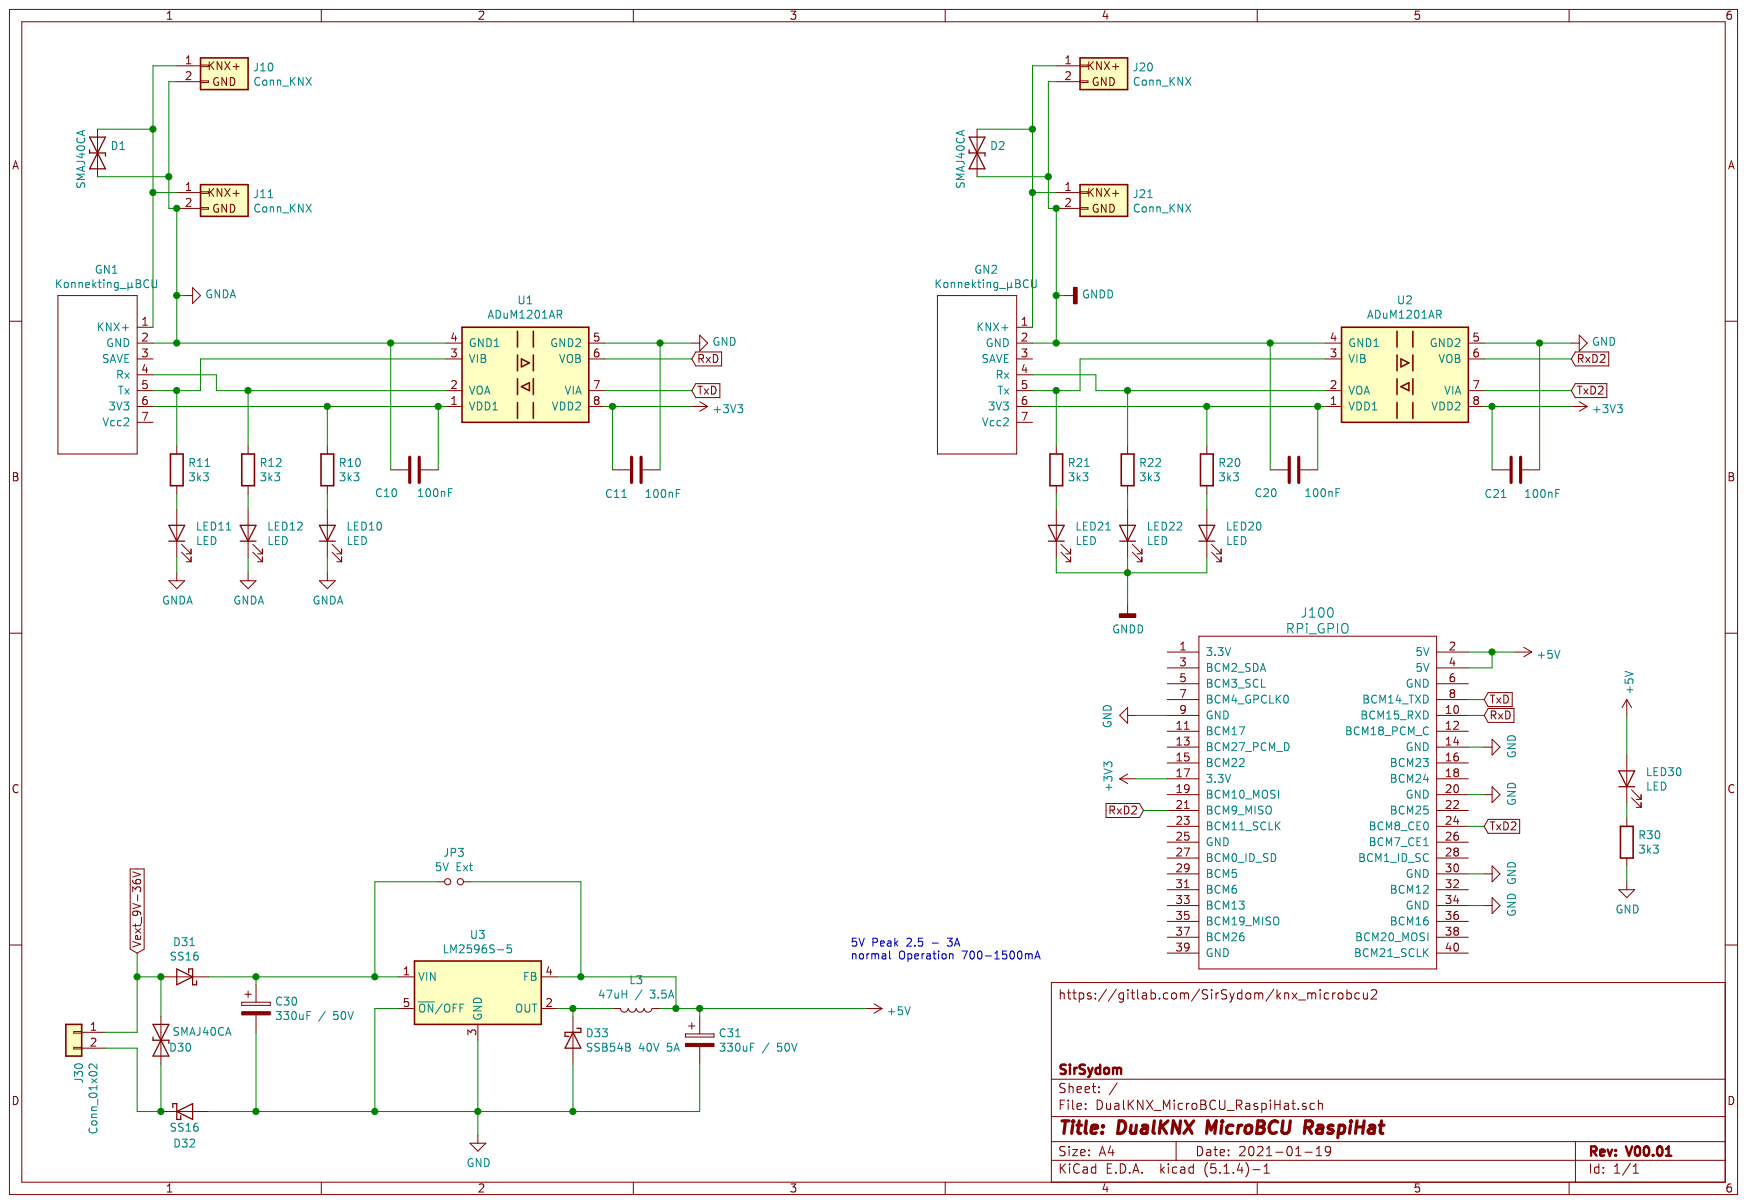
[picture p40: page 1]
