OpenKNX/OpenKNX-RasPi-HAT/doc/DualKNX_MicroBCU_RaspiHat_Schematic_V00.03.pdf

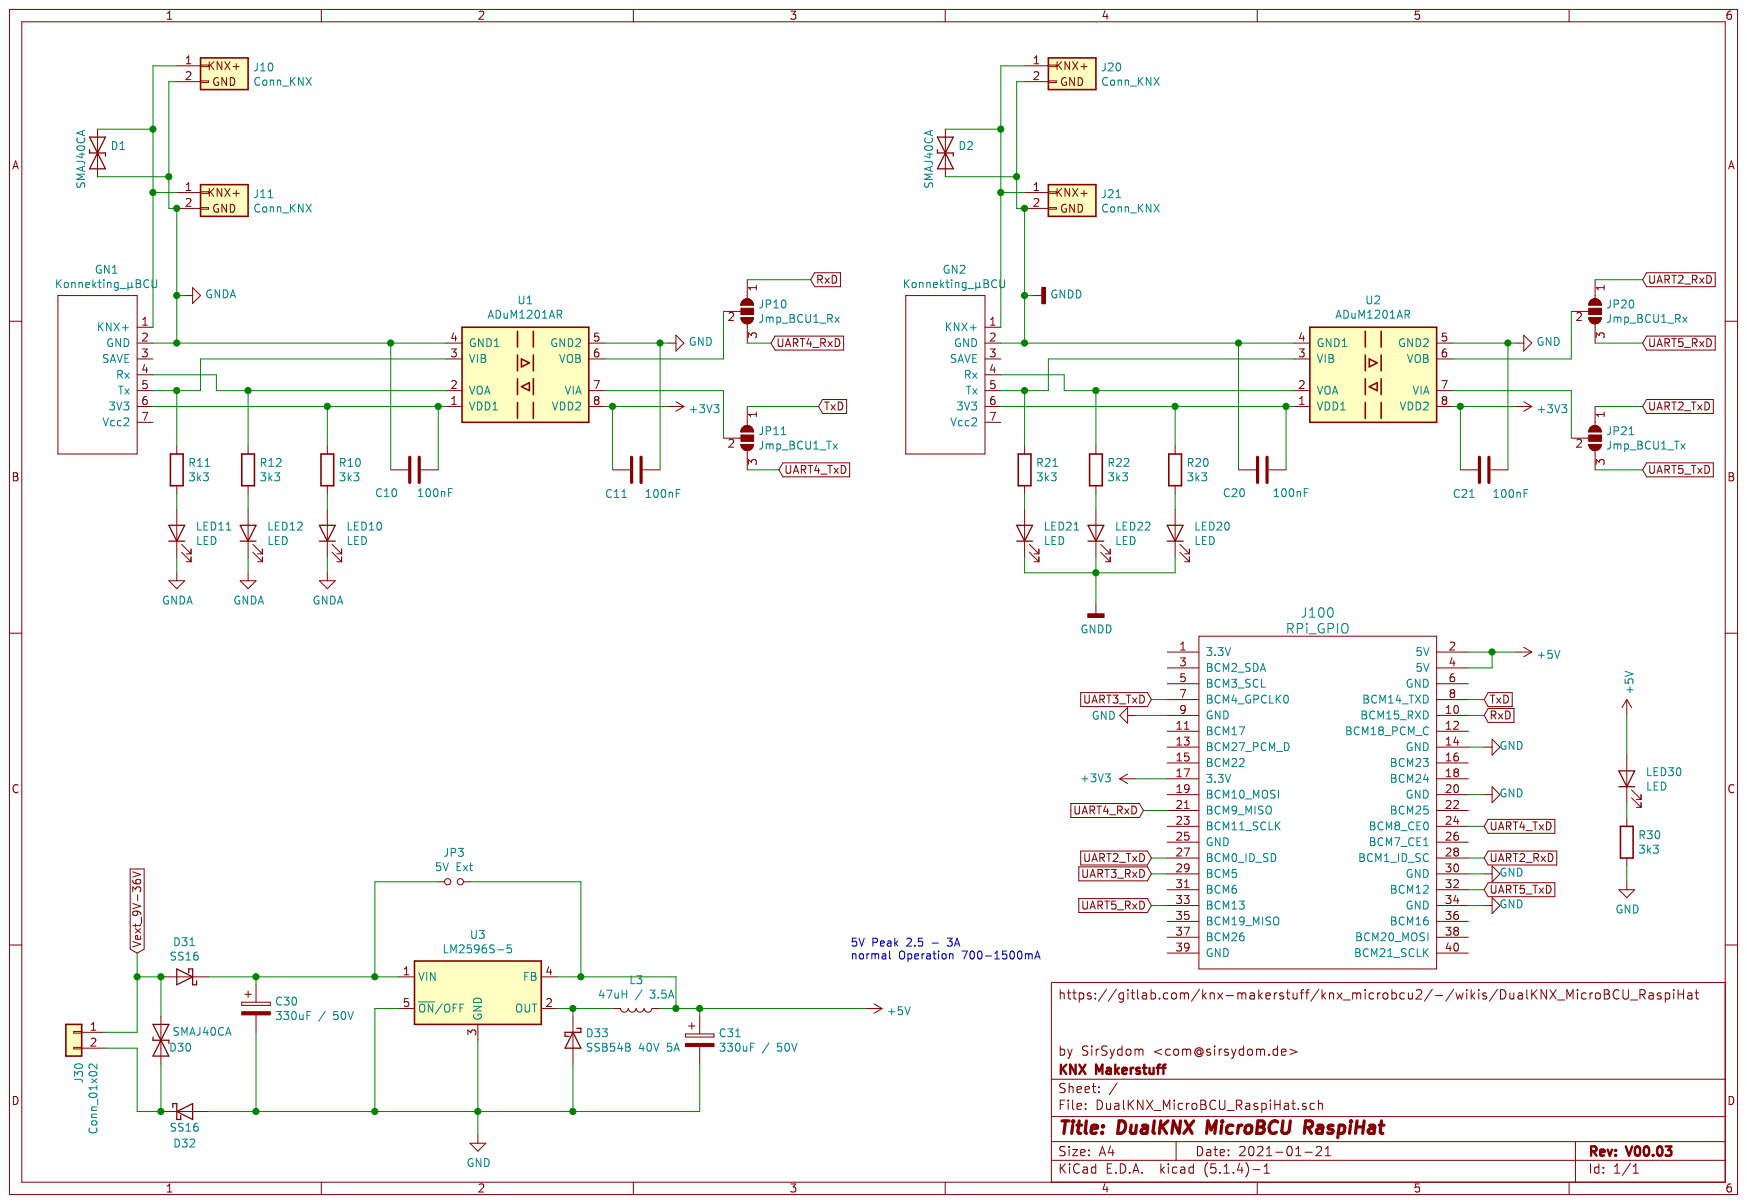
[picture p41: page 1]
