OpenKNX/OpenKNX-RasPi-HAT/hardware/EDA-Files/RasPi-HAT/RasPi-HAT.kicad_pcb

## KiCad design hardware/EDA-Files/RasPi-HAT/RasPi-HAT.kicad_pcb (2024-07-27)

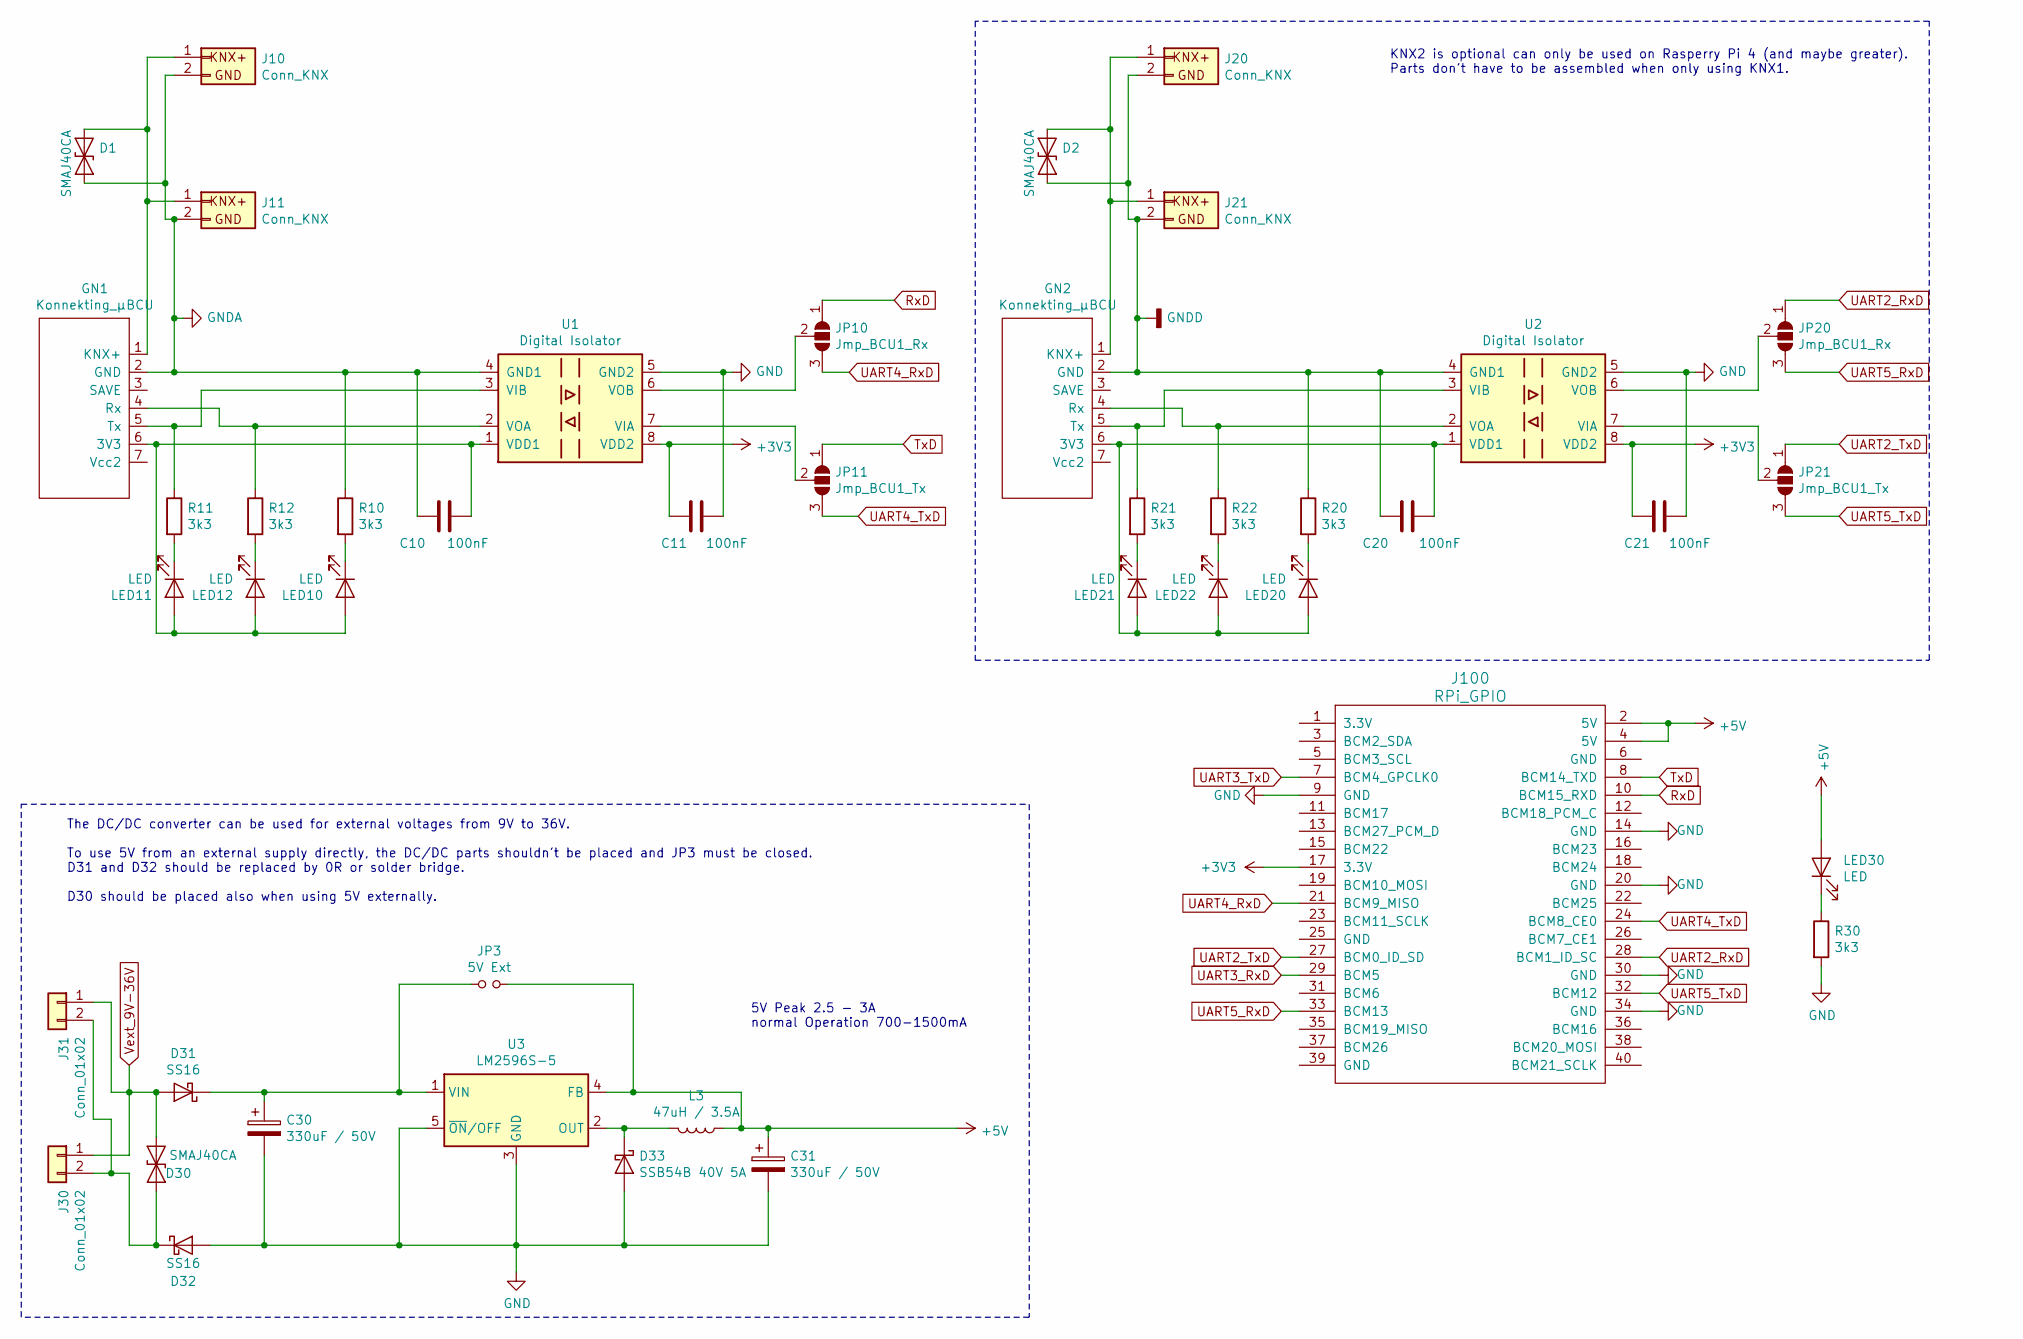
[picture p42: schematic RasPi-HAT.sch, RasPi HAT]

Parts:
C10, C11, C20, C21: 100nF; C_0603_1608Metric
C30, C31: 330uF / 50V; CP_Radial_D10.0mm_P5.00mm
D1, D2, D30: SMAJ40CA; D_SMA
D31, D32: SS16; D_SMA
D33: SSB54B 40V 5A; D_SMB
GN1, GN2: Konnekting_µBCU; MicroBCU2_PinHeader_SMD
J10, J20: Conn_KNX; KNX_Connector
J11, J21: Conn_KNX; PinHeader_1x02_P2.54mm_Vertical
J30: Conn_01x02; KNX_Connector
J31: Conn_01x02; PhoenixContact_MSTBA_2,5_2-G-5,08_1x02_P5.08mm_Horizontal
J100: RPi_GPIO; PinSocket_2x20_P2.54mm_Vertical
JP3: 5V Ext; PinHeader_1x02_P2.54mm_Vertical
JP10, JP20: Jmp_BCU1_Rx; SolderJumper-3_P1.3mm_Open_RoundedPad1.0x1.5mm
JP11, JP21: Jmp_BCU1_Tx; SolderJumper-3_P1.3mm_Open_RoundedPad1.0x1.5mm
L3: 47uH / 3.5A; L_YJYCOIN_YSPI1365_13.8mmx12.6mm_H6.5mm
LED10, LED11, LED12, LED20, LED21, LED22, LED30: LED; LED_0805_2012Metric_Castellated
R10, R11, R12, R20, R21, R22, R30: 3k3; R_0805_2012Metric_Pad1.15x1.40mm_HandSolder
U1, U2: Digital Isolator; SOIC-8_3.9x4.9mm_P1.27mm
U3: LM2596S-5; TO-263-5_TabPin3

Connections:
+3V3: C11.2, C21.2, J100.17 (3.3V), U1.8 (VDD2), U2.8 (VDD2)
+5V: C31.1, J100.2 (5V), J100.4 (5V), JP3.2, L3.1, LED30.2 (A), U3.4 (FB)
GND: C11.1, C21.1, C30.2, C31.2, D32.2 (A), D33.2 (A), J100.9 (GND), J100.14 (GND), J100.20 (GND), J100.30 (GND), J100.34 (GND), R30.2, U1.5 (GND2), U2.5 (GND2), U3.3 (GND), U3.5 (~ON~/OFF)
GNDA: C10.1, D1.2 (A2), GN1.2 (GND), J10.2, J11.2, R10.1, U1.4 (GND1)
GNDD: C20.1, D2.2 (A2), GN2.2 (GND), J20.2, J21.2, R20.1, U2.4 (GND1)
unnamed: C10.2, GN1.6 (3V3), LED10.2 (A), LED11.2 (A), LED12.2 (A), U1.1 (VDD1)
unnamed: C20.2, GN2.6 (3V3), LED20.2 (A), LED21.2 (A), LED22.2 (A), U2.1 (VDD1)
unnamed: C30.1, D31.1 (K), JP3.1, U3.1 (VIN)
unnamed: D1.1 (A1), GN1.1 (KNX+), J10.1, J11.1
unnamed: D2.1 (A1), GN2.1 (KNX+), J20.1, J21.1
unnamed: D30.1 (A1), D32.1 (K), J30.2, J31.2
unnamed: D33.1 (K), L3.2, U3.2 (OUT)
unnamed: GN1.4 (Rx), R12.1, U1.2 (VOA)
unnamed: GN1.5 (Tx), R11.1, U1.3 (VIB)
unnamed: GN2.4 (Rx), R22.1, U2.2 (VOA)
unnamed: GN2.5 (Tx), R21.1, U2.3 (VIB)
unnamed: JP10.2 (C), U1.6 (VOB)
unnamed: JP11.2 (C), U1.7 (VIA)
unnamed: JP20.2 (C), U2.6 (VOB)
unnamed: JP21.2 (C), U2.7 (VIA)
unnamed: LED10.1 (K), R10.2
unnamed: LED11.1 (K), R11.2
unnamed: LED12.1 (K), R12.2
unnamed: LED20.1 (K), R20.2
unnamed: LED21.1 (K), R21.2
unnamed: LED22.1 (K), R22.2
unnamed: LED30.1 (K), R30.1
RxD: J100.10 (BCM15_RXD), JP10.1 (A)
TxD: J100.8 (BCM14_TXD), JP11.1 (A)
UART2_RxD: J100.28 (BCM1_ID_SC), JP20.1 (A)
UART2_TxD: J100.27 (BCM0_ID_SD), JP21.1 (A)
UART3_RxD: J100.29 (BCM5)
UART3_TxD: J100.7 (BCM4_GPCLK0)
UART4_RxD: J100.21 (BCM9_MISO), JP10.3 (B)
UART4_TxD: J100.24 (BCM8_CE0), JP11.3 (B)
UART5_RxD: J100.33 (BCM13), JP20.3 (B)
UART5_TxD: J100.32 (BCM12), JP21.3 (B)
Vext_9V-36V: D30.2 (A2), D31.2 (A), J30.1, J31.1

Notes on the sheet:
The DC/DC converter can be used for external voltages from 9V to 36V. To use 5V from an external supply directly, the DC/DC parts shouldn't be placed and JP3 must be closed. D31 and D32 should be replaced by 0R or solder bridge. D30 should be placed also when using 5V externally.
5V Peak 2.5 - 3A normal Operation 700-1500mA
KNX2 is optional can only be used on Rasperry Pi 4 (and maybe greater). Parts don't have to be assembled when only using KNX1.

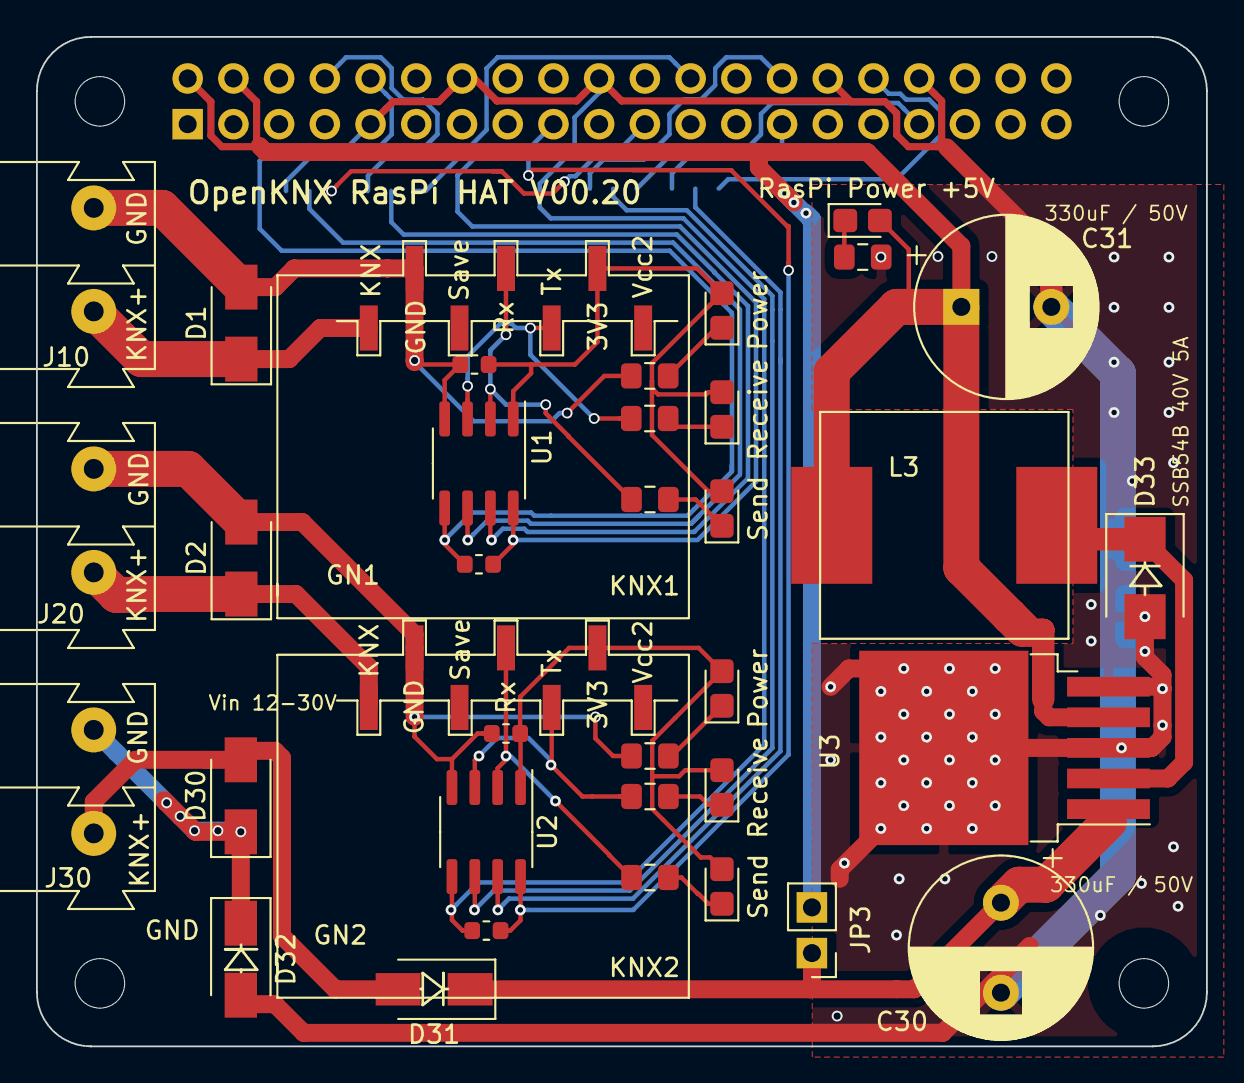
[picture p43: board RasPi-HAT.kicad_pcb from above]

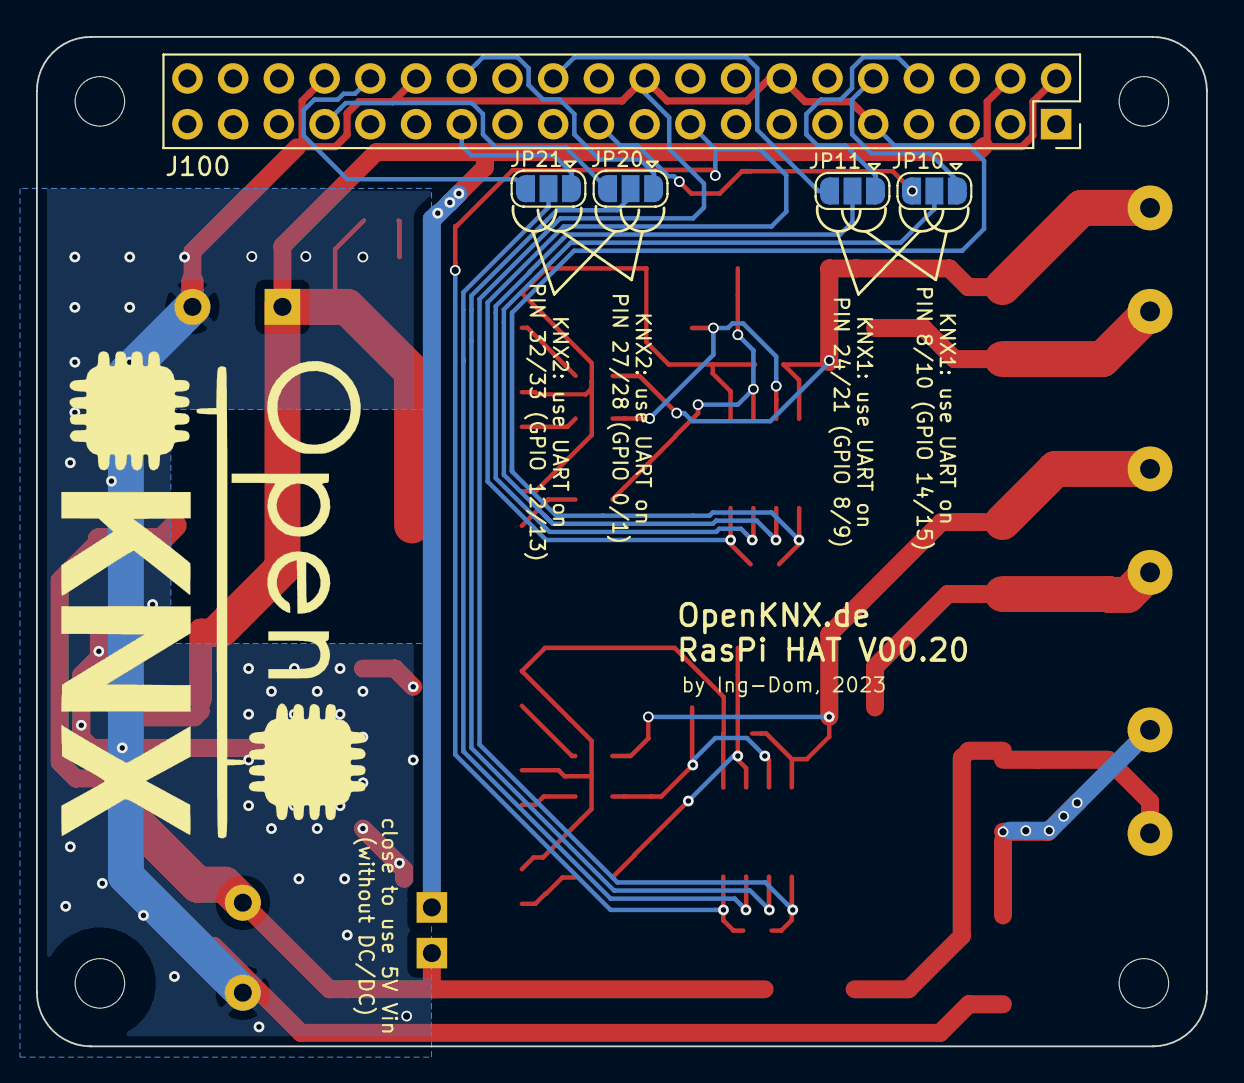
[picture p44: board RasPi-HAT.kicad_pcb from below]

Board: 2 copper layers, 65.0 x 56.1 mm, 41 parts (5 on the bottom side), 36 nets.
