OpenKNX/OpenKNX-RasPi-HAT/(commit log)

2022-06-21 added V00.10 schematic
2023-01-05 added stuff for RasPi-Case
2023-01-25 added RasPi-Case V00.90
    [RasPi-Case_KNX-Adapter.stl, RasPi-Case_Spacer11mm.stl, RasPi-Case_Wago-Adapter.stl, RasPi_Main_Case.stl, RasPi_Main_CaseCover.stl]
2024-07-27 release RasPi-HAT V00.20 KiCAD project
    [RasPi-HAT-B_Cu.gbr, RasPi-HAT-B_Mask.gbr, RasPi-HAT-B_Paste.gbr, RasPi-HAT-B_SilkS.gbr, RasPi-HAT-Edge_Cuts.gbr, RasPi-HAT-F_Cu.gbr, RasPi-HAT-F_Mask.gbr, RasPi-HAT-F_Paste.gbr]
